xtech/hw-openmower-worx/README.md

# OpenMower Mainboard for Worx Mowers

## Information

This hardware version is in development. Nothing works, this is not nearly done!!

## About This Repo

OpenMower is an open-source project that upgrades off-the-shelf robotic mowers into modern, smart lawn mowing robots with RTK GPS technology. For more details, check out the [OpenMower project](https://github.com/clemensElflein/openmower).

This repository contains the design files for a custom mainboard specifically designed for converting YardForce mowers to OpenMower. 

## List of Compatible Mowers

This mainboard is compatible with the following mower models:

- YardForce Classic 500(B)
- YardForce SA-series mowers (SA650, SA900, ...)

## Additional Information

This mainboard is the reference board for OpenMower and includes more features than actually required to build an OpenMower robot. This way it can be used as a template for other mower models. Additional features include a gigabit Ethernet switch, LiPo charger, and a 12V auxiliary power supply for extensions.

## Patents, Local Laws, Liability

Before building a robot based on the designs published here, please make sure that you are allowed to do so in your specific regions.
There may be patents and / or laws prohibiting you of doing so.

The code/schematics/PCB files are distributed in the hope that it will be useful, but WITHOUT ANY WARRANTY; without even the implied warranty of MERCHANTABILITY or FITNESS FOR A PARTICULAR PURPOSE.

This basically means: I'm just documenting a project of mine here for free and I don't have the time and resources to check that devices built using this information will be safe to use, legal to use or even work as intended. You will need technical know-how to use this project and I'm not liable for any damages your devices do to anyone or anything.

## License

<br />This work is licensed under a <a rel="license" href="https://creativecommons.org/licenses/by/4.0/">Creative Commons Attribution 4.0 International License</a>.
