xtech/hw-openmower-worx/components/extern/3dmodels/Connectors/XT60PW-M.STEP

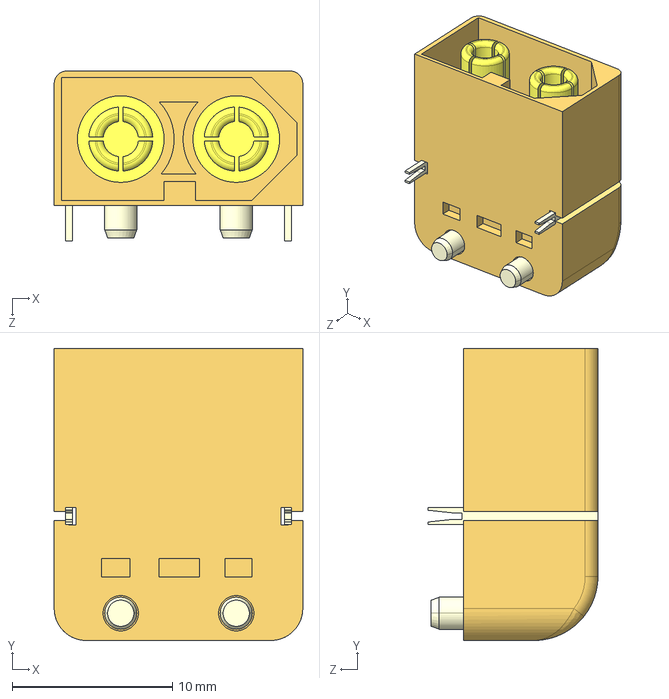
[picture p1: CAD file, 2024-10-06]
components/extern/3dmodels/Connectors/XT60PW-M.STEP
15.5 x 18.2 x 10.6 mm
