xtech/hw-openmower-worx/3d/FuseClip.stp

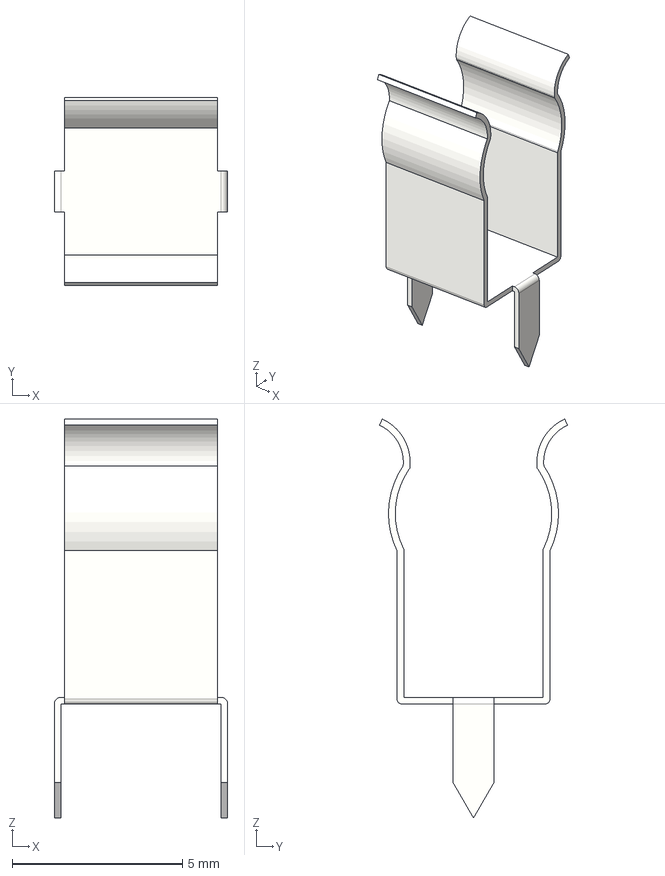
[picture p2: CAD file, 2024-10-06]
3d/FuseClip.stp
5.10 x 5.53 x 11.7 mm
