xtech/hw-openmower-worx/components/extern/3dmodels/Connectors/XT60PW FEMALE.STEP

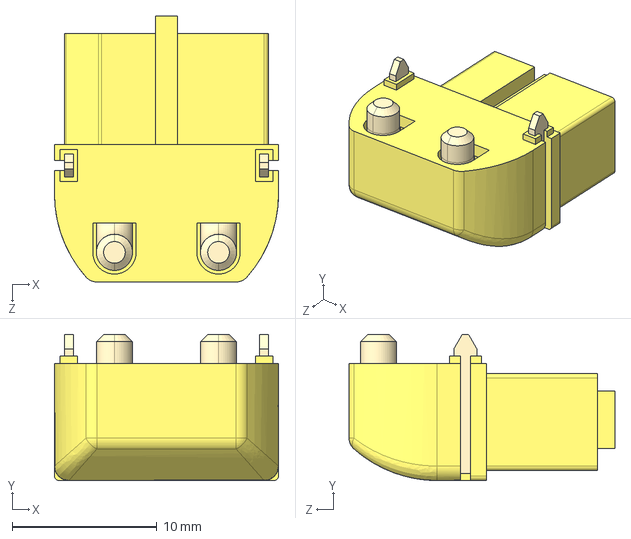
[picture p3: CAD file, 2024-10-06]
components/extern/3dmodels/Connectors/XT60PW FEMALE.STEP
15.5 x 10.1 x 18.4 mm
