xtech/hw-openmower-worx/components/extern/3dmodels/Connectors/XT60PW MALE.STEP

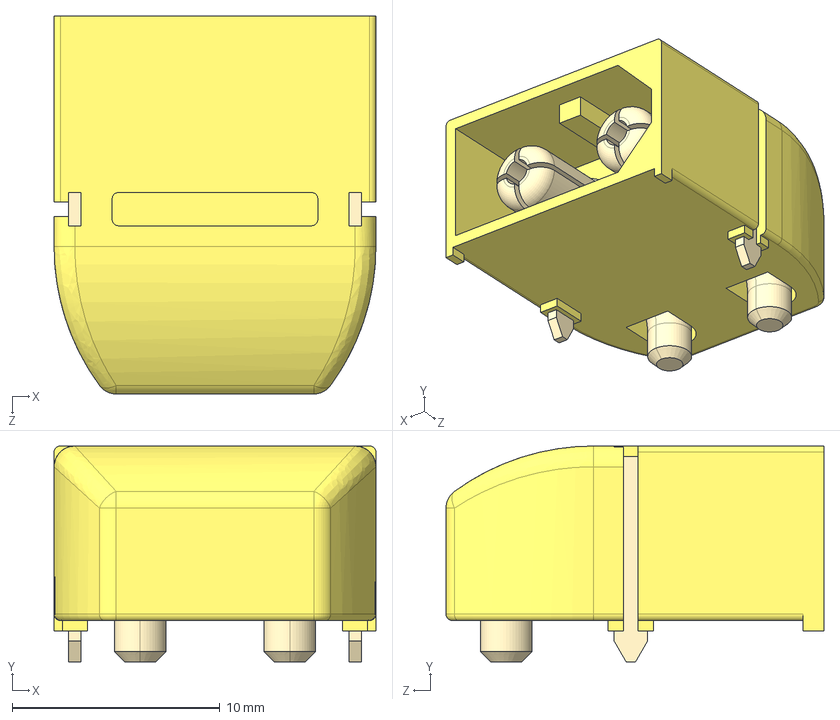
[picture p6: CAD file, 2024-10-06]
components/extern/3dmodels/Connectors/XT60PW MALE.STEP
15.5 x 10.4 x 18.2 mm
