xtech/hw-openmower-worx/3d/039281083_stp/039281083.stp

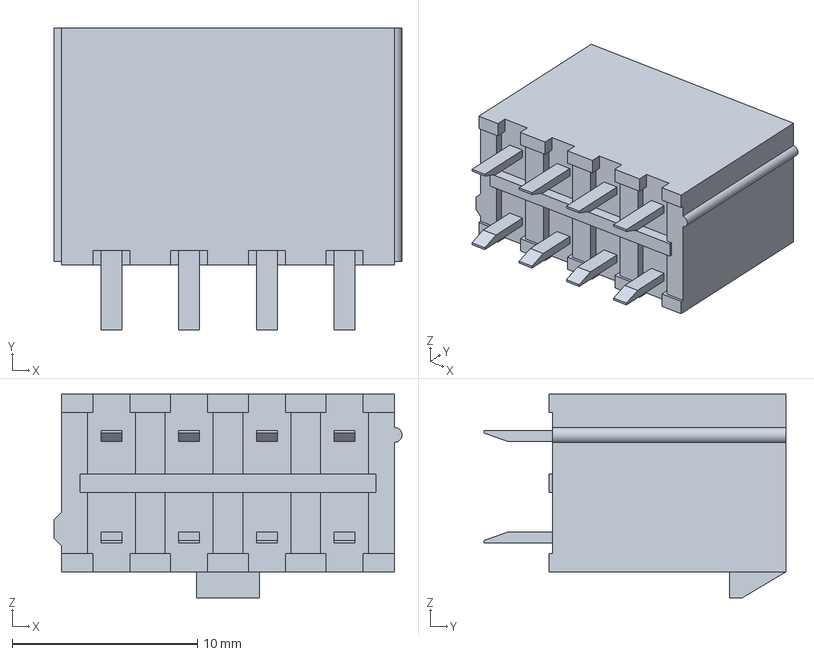
[picture p8: CAD file, 2024-10-06]
3d/039281083_stp/039281083.stp
18.8 x 16.3 x 11.0 mm
