xtech/hw-openmower-worx/components/extern/3dmodels/local_CHARGER/BQ25756RRVR.step

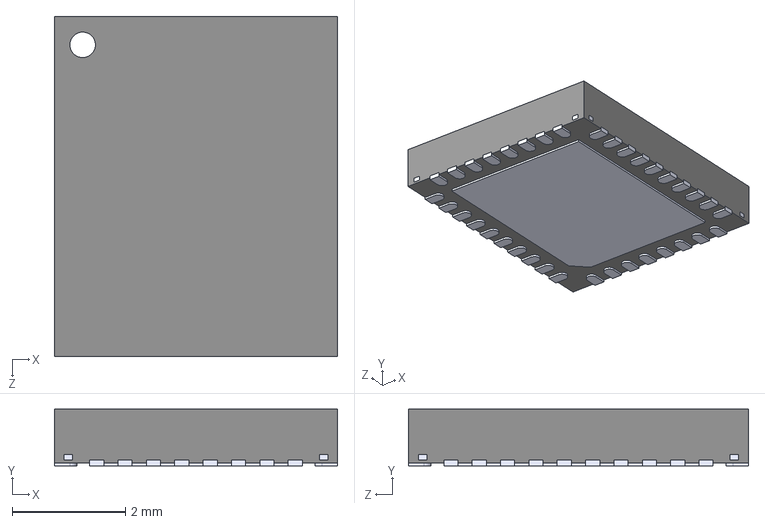
[picture p11: CAD file, 2024-10-06]
components/extern/3dmodels/local_CHARGER/BQ25756RRVR.step
5.00 x 1.00 x 6.00 mm
