xtech/hw-openmower-worx/Amplifier.kicad_sch

## KiCad design Amplifier.kicad_sch (2024-10-06)

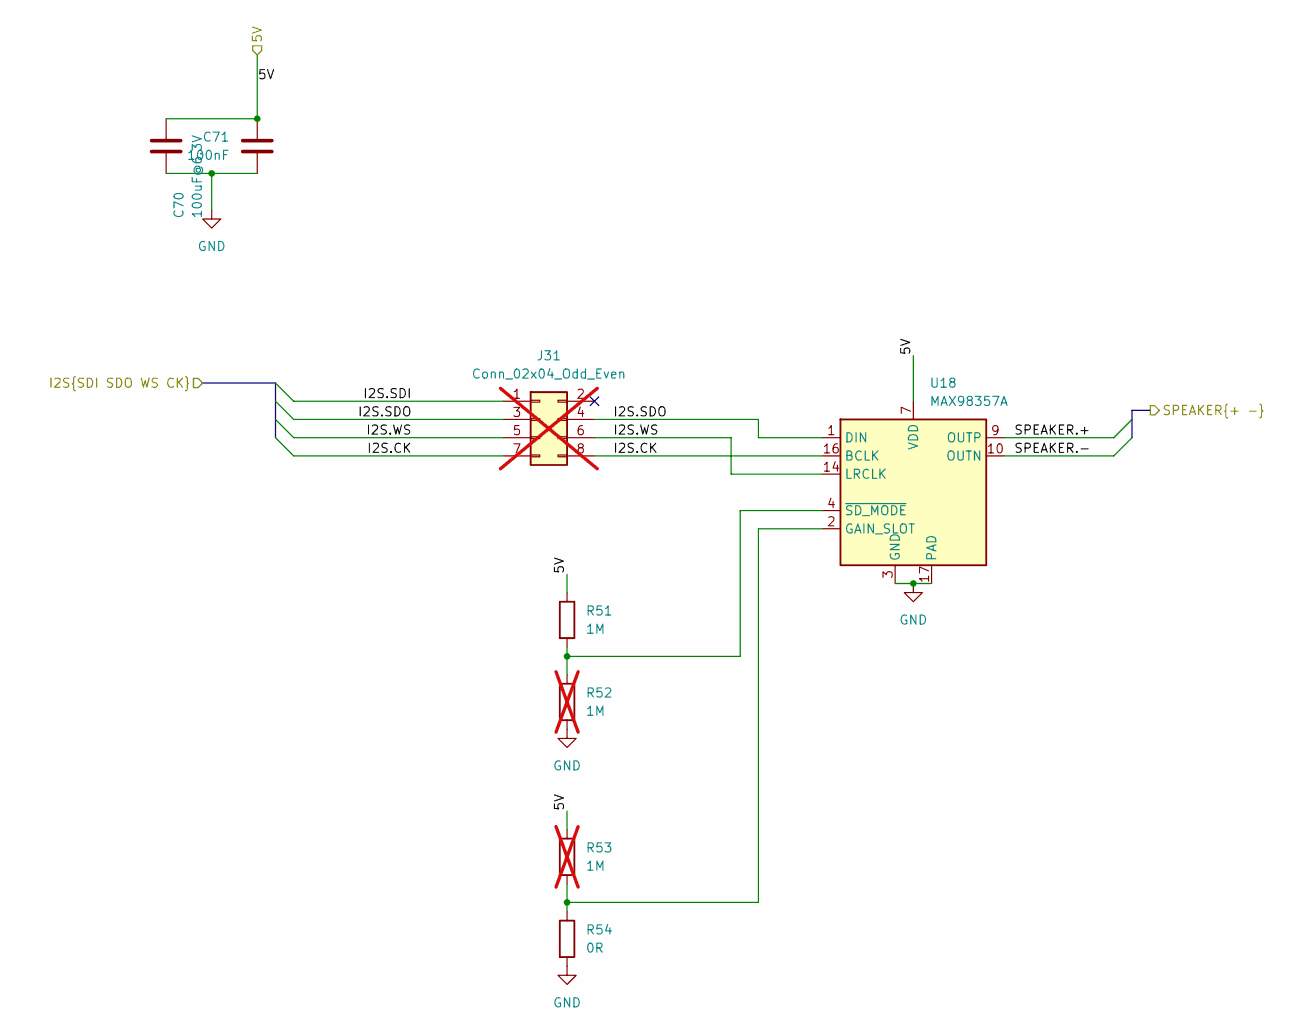
[picture p14: schematic Amplifier.kicad_sch]

Parts:
C70: 100uF@6.3V; C_1206_3216Metric; JLC C15008
C71: 100nF; C_0402_1005Metric; JLC C307331
J31: Conn_02x04_Odd_Even; PinHeader_2x04_P2.54mm_Vertical; not fitted
R51: 1M; R_0805_2012Metric; JLC C17514
R52, R53: 1M; R_0805_2012Metric; JLC C17514; not fitted
R54: 0R; R_0805_2012Metric; JLC C17477
U18: MAX98357A; TQFN-16-1EP_3x3mm_P0.5mm_EP1.23x1.23mm; JLC C910544

Connections:
5V: C70.1, C71.2, R51.1, R53.1, U18.7 (VDD), U18.8 (VDD)
GND: C70.2, C71.1, R52.2, R54.2, U18.3 (GND), U18.11 (GND), U18.15 (GND), U18.17 (PAD)
I2S.CK: J31.7, J31.8, U18.16 (BCLK)
I2S.SDI: J31.1
I2S.SDO: J31.3, J31.4, U18.1 (DIN)
I2S.WS: J31.5, J31.6, U18.14 (LRCLK)
unnamed: R51.2, R52.1, U18.4 (~SD_MODE)
unnamed: R53.2, R54.1, U18.2 (GAIN_SLOT)
SPEAKER.+: U18.9 (OUTP)
SPEAKER.-: U18.10 (OUTN)
