xtech/hw-openmower-worx/AuxPSU.kicad_sch

## KiCad design AuxPSU.kicad_sch (2024-10-06)

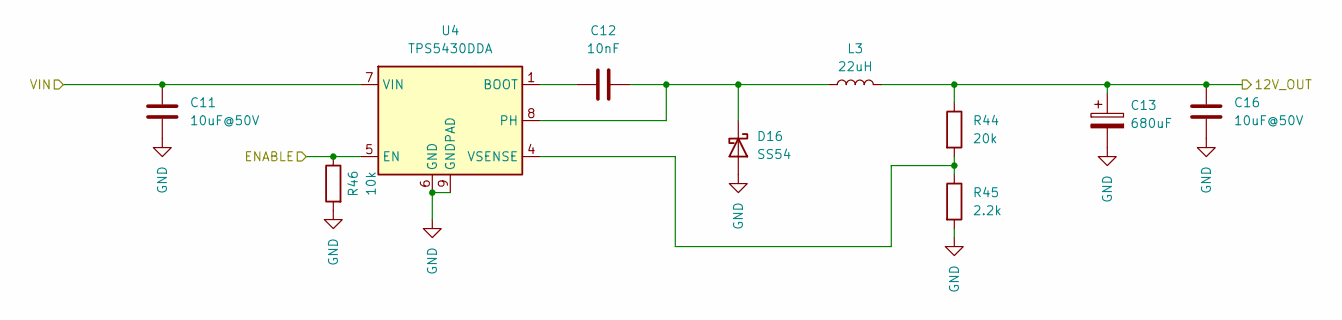
[picture p15: schematic AuxPSU.kicad_sch]

Parts:
C11, C16: 10uF@50V; C_1206_3216Metric; JLC C13585
C12: 10nF; C_0805_2012Metric; JLC C1710
C13: 680uF; CP_Elec_10x12.5; Part Number GVM1V681M1010; Digikey P124828TR-ND
D16: SS54; D_SMA; JLC C22452
L3: 22uH; L_Sunlord_MWSA1004S; JLC C408489
R44: 20k; R_0805_2012Metric; JLC C4328
R45: 2.2k; R_0805_2012Metric; JLC C17520
R46: 10k; R_0402_1005Metric; JLC C25744
U4: TPS5430DDA; TI_SO-PowerPAD-8_ThermalVias; JLC C9864

Connections:
12V_OUT: C13.1, C16.1, L3.2, R44.1
ENABLE: R46.1, U4.5 (EN)
GND: C11.2, C13.2, C16.2, D16.2 (A), R45.2, R46.2, U4.6 (GND), U4.9 (GNDPAD)
unnamed: C12.1, U4.1 (BOOT)
unnamed: C12.2, D16.1 (K), L3.1, U4.8 (PH)
unnamed: R44.2, R45.1, U4.4 (VSENSE)
VIN: C11.1, U4.7 (VIN)
