xtech/hw-openmower-worx/Charger.kicad_sch

## KiCad design Charger.kicad_sch (2024-10-06)

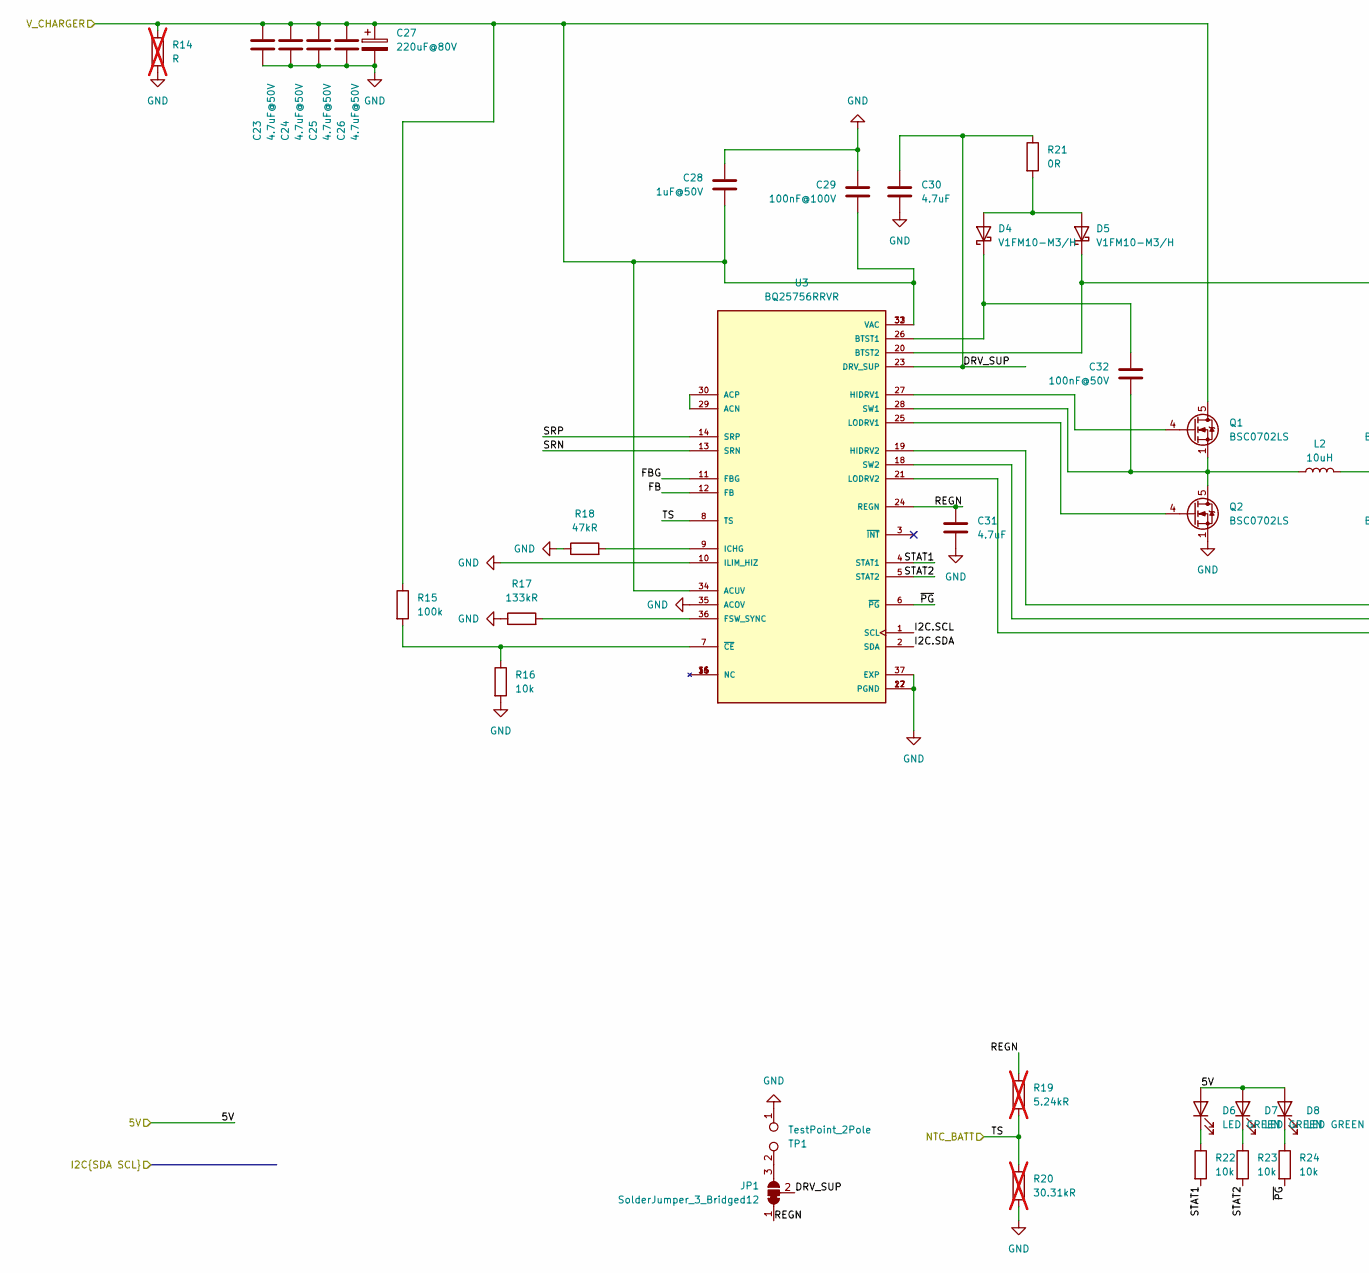
[picture p16: schematic Charger.kicad_sch, part in row 1, column 1]

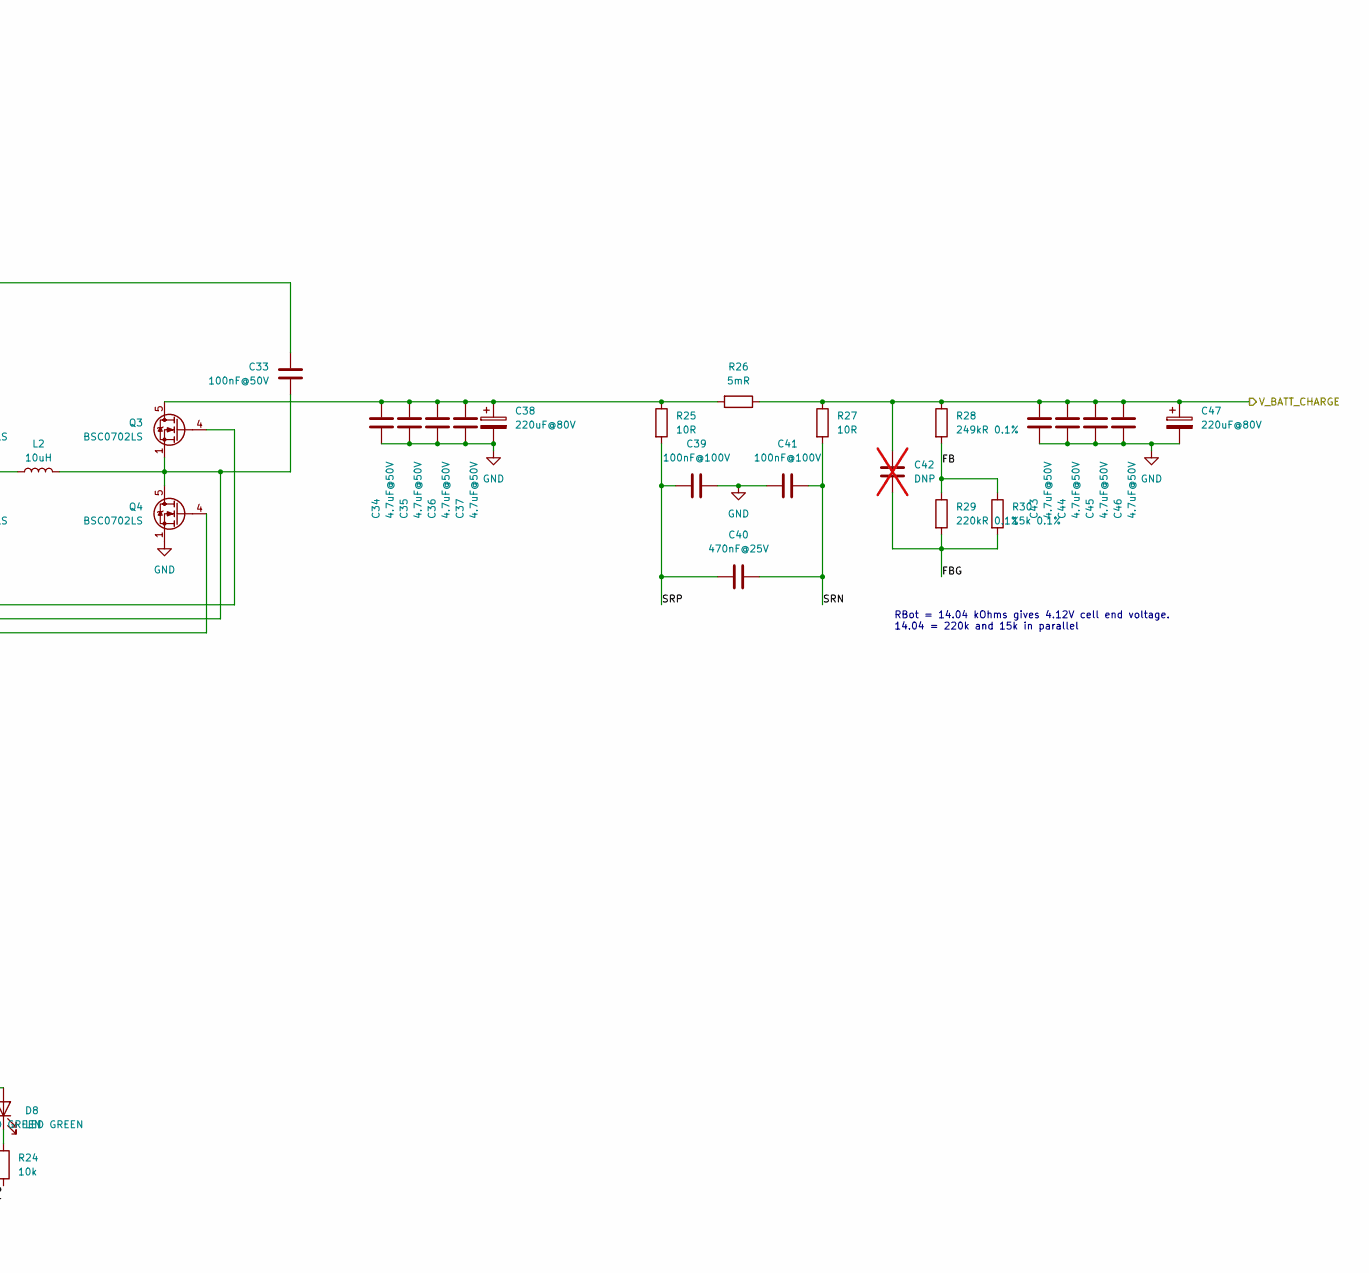
[picture p17: schematic Charger.kicad_sch, part in row 1, column 2]

Parts:
C23, C24, C25, C26, C34, C35, C36, C37, C43, C44, C45, C46: 4.7uF@50V; C_1206_3216Metric; JLC C29823
C27, C38, C47: 220uF@80V; CP_Radial_D10.0mm_P5.00mm; JLC C106516
C28: 1uF@50V; C_0805_2012Metric; JLC C354368
C29, C39, C41: 100nF@100V; C_0805_2012Metric; JLC C28233
C30, C31: 4.7uF; C_0805_2012Metric; JLC C1779
C32, C33: 100nF@50V; C_0402_1005Metric; JLC C307331
C40: 470nF@25V; C_0603_1608Metric; JLC C1623
C42: DNP; C_0603_1608Metric; not fitted
D4, D5: V1FM10-M3/H; D_SMF; JLC C3758930
D6, D7, D8: LED GREEN; LED_0805_2012Metric; JLC C2297
JP1: SolderJumper_3_Bridged12; SolderJumper-3_P1.3mm_Bridged12_Pad1.0x1.5mm
L2: 10uH; L_Sunlord_MWSA1004S; JLC C408487
Q1, Q2, Q3, Q4: BSC0702LS; TDSON-8-1; JLC C501503
R14: R; R_1206_3216Metric; not fitted
R15: 100k; R_0402_1005Metric; JLC C25741
R16, R22, R23, R24: 10k; R_0402_1005Metric; JLC C25744
R17: 133kR; R_0603_1608Metric; JLC C227577
R18: 47kR; R_0603_1608Metric; JLC C25819
R19: 5.24kR; R_0603_1608Metric; not fitted
R20: 30.31kR; R_0603_1608Metric; not fitted
R21: 0R; R_0805_2012Metric; JLC C17477
R25, R27: 10R; R_0402_1005Metric; JLC C25077
R26: 5mR; R_2512_6332Metric; JLC C309526
R28: 249kR 0.1%; R_0603_1608Metric; JLC C705752
R29: 220kR 0.1%; R_0603_1608Metric; JLC C861231
R30: 15k 0.1%; R_0603_1608Metric; JLC C2692707
TP1: TestPoint_2Pole; PinHeader_1x02_P2.54mm_Vertical
U3: BQ25756RRVR; PARTREV August 2023; JLC C19272232

Connections:
5V: D6.2 (A), D7.2 (A), D8.2 (A)
DRV_SUP: C30.1, JP1.2 (C), R21.1, U3.23 (DRV_SUP)
FB: R28.2, R29.1, R30.1, U3.12 (FB)
FBG: C42.2, R29.2, R30.2, U3.11 (FBG)
GND: C23.2, C24.2, C25.2, C26.2, C27.2, C28.2, C29.2, C30.2, C31.2, C34.2, C35.2, C36.2, C37.2, C38.2, C39.1, C41.2, C43.2, C44.2, C45.2, C46.2, C47.2, Q2.1 (S), Q2.2 (S), Q2.3 (S), Q4.1 (S), Q4.2 (S), Q4.3 (S), R14.2, R16.2, R17.1, R18.1, R20.2, TP1.1, U3.10 (ILIM_HIZ), U3.17 (PGND), U3.22 (PGND), U3.35 (ACOV), U3.37 (EXP)
I2C.SCL: U3.1 (SCL)
I2C.SDA: U3.2 (SDA)
NTC_BATT: R19.2, R20.1, U3.8 (TS)
unnamed: C32.1, L2.1, Q1.1 (S), Q1.2 (S), Q1.3 (S), Q2.5 (D), U3.28 (SW1)
unnamed: C32.2, D4.1 (K), U3.26 (BTST1)
unnamed: C33.1, L2.2, Q3.1 (S), Q3.2 (S), Q3.3 (S), Q4.5 (D), U3.18 (SW2)
unnamed: C33.2, D5.1 (K), U3.20 (BTST2)
unnamed: C34.1, C35.1, C36.1, C37.1, C38.1, Q3.5 (D), R25.1, R26.2
unnamed: D4.2 (A), D5.2 (A), R21.2
unnamed: D6.1 (K), R22.1
unnamed: D7.1 (K), R23.1
unnamed: D8.1 (K), R24.1
unnamed: JP1.3 (B), TP1.2
unnamed: Q1.4 (G), U3.27 (HIDRV1)
unnamed: Q2.4 (G), U3.25 (LODRV1)
unnamed: Q3.4 (G), U3.19 (HIDRV2)
unnamed: Q4.4 (G), U3.21 (LODRV2)
unnamed: R15.2, R16.1, U3.7 (~CE)
unnamed: R17.2, U3.36 (FSW_SYNC)
unnamed: R18.2, U3.9 (ICHG)
unnamed: U3.15 (NC), U3.16 (NC), U3.31 (NC)
unnamed: U3.29 (ACN), U3.30 (ACP)
REGN: C31.1, JP1.1 (A), R19.1, U3.24 (REGN)
SRN: C40.2, C41.1, R27.2, U3.13 (SRN)
SRP: C39.2, C40.1, R25.2, U3.14 (SRP)
STAT1: R22.2, U3.4 (STAT1)
STAT2: R23.2, U3.5 (STAT2)
V_BATT_CHARGE: C42.1, C43.1, C44.1, C45.1, C46.1, C47.1, R26.1, R27.1, R28.1
V_CHARGER: C23.1, C24.1, C25.1, C26.1, C27.1, C28.1, C29.1, Q1.5 (D), R14.1, R15.1, U3.32 (VAC), U3.33 (VAC), U3.34 (ACUV)
~PG: R24.2, U3.6 (~PG)

Notes on the sheet:
RBot = 14.04 kOhms gives 4.12V cell end voltage. 14.04 = 220k and 15k in parallel
