xtech/hw-openmower-worx/Connectors.kicad_sch

## KiCad design Connectors.kicad_sch (2024-10-06)

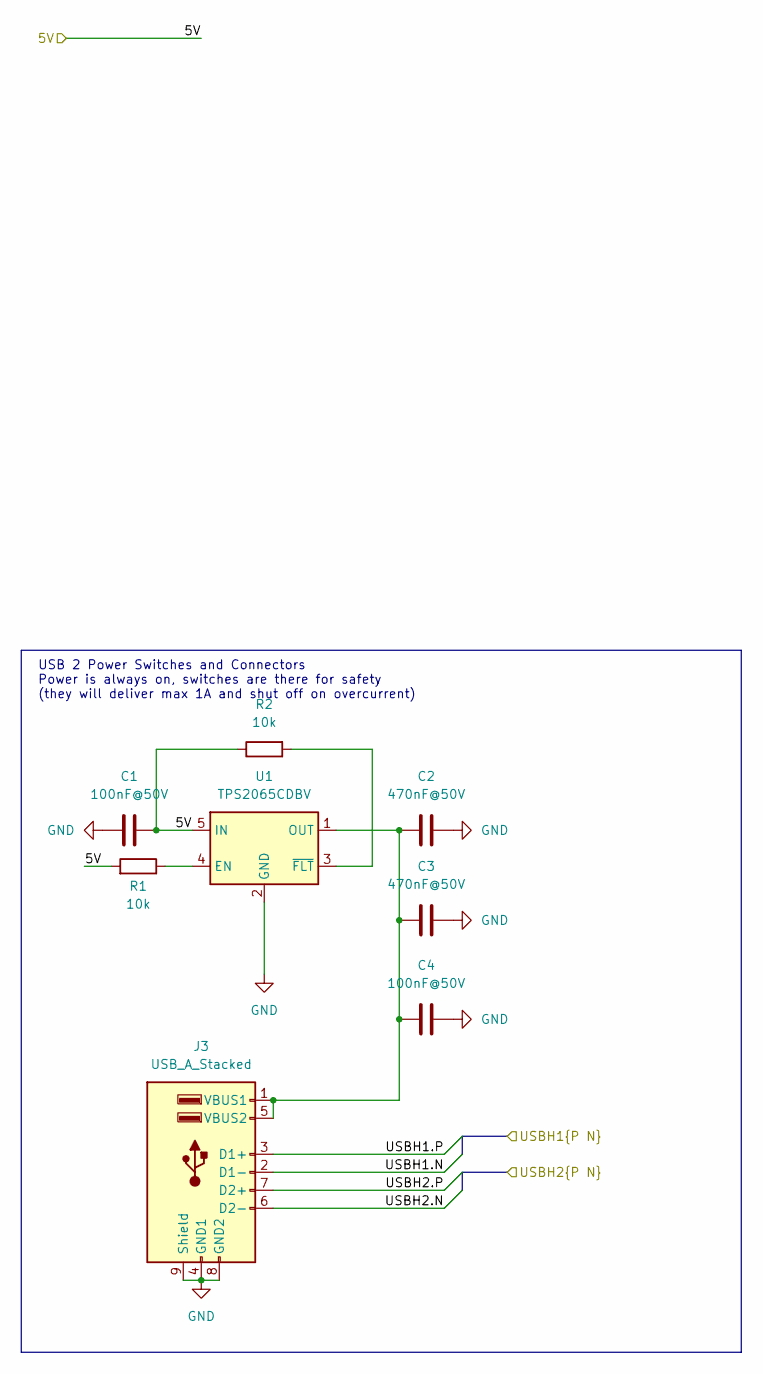
[picture p18: schematic Connectors.kicad_sch]

Parts:
C1, C4: 100nF@50V; C_0402_1005Metric; JLC C307331
C2, C3: 470nF@50V; C_0805_2012Metric; JLC C13967
J3: USB_A_Stacked; USB_A_Wuerth_61400826021_Horizontal_Stacked; JLC C720548
R1, R2: 10k; R_0402_1005Metric; JLC C25744
U1: TPS2065CDBV; SOT-23-5; JLC C353882

Connections:
5V: C1.1, R1.2, R2.1, U1.5 (IN)
GND: C1.2, C2.2, C3.2, C4.1, J3.4 (GND1), J3.8 (GND2), J3.9 (Shield), U1.2 (GND)
unnamed: C2.1, C3.1, C4.2, J3.1 (VBUS1), J3.5 (VBUS2), U1.1 (OUT)
unnamed: R1.1, U1.4 (EN)
unnamed: R2.2, U1.3 (~FLT)
USBH1.N: J3.2 (D1-)
USBH1.P: J3.3 (D1+)
USBH2.N: J3.6 (D2-)
USBH2.P: J3.7 (D2+)

Notes on the sheet:
USB 2 Power Switches and Connectors Power is always on, switches are there for safety (they will deliver max 1A and shut off on overcurrent)
