xtech/hw-openmower-worx/Core.kicad_sch

## KiCad design Core.kicad_sch (2024-10-06)

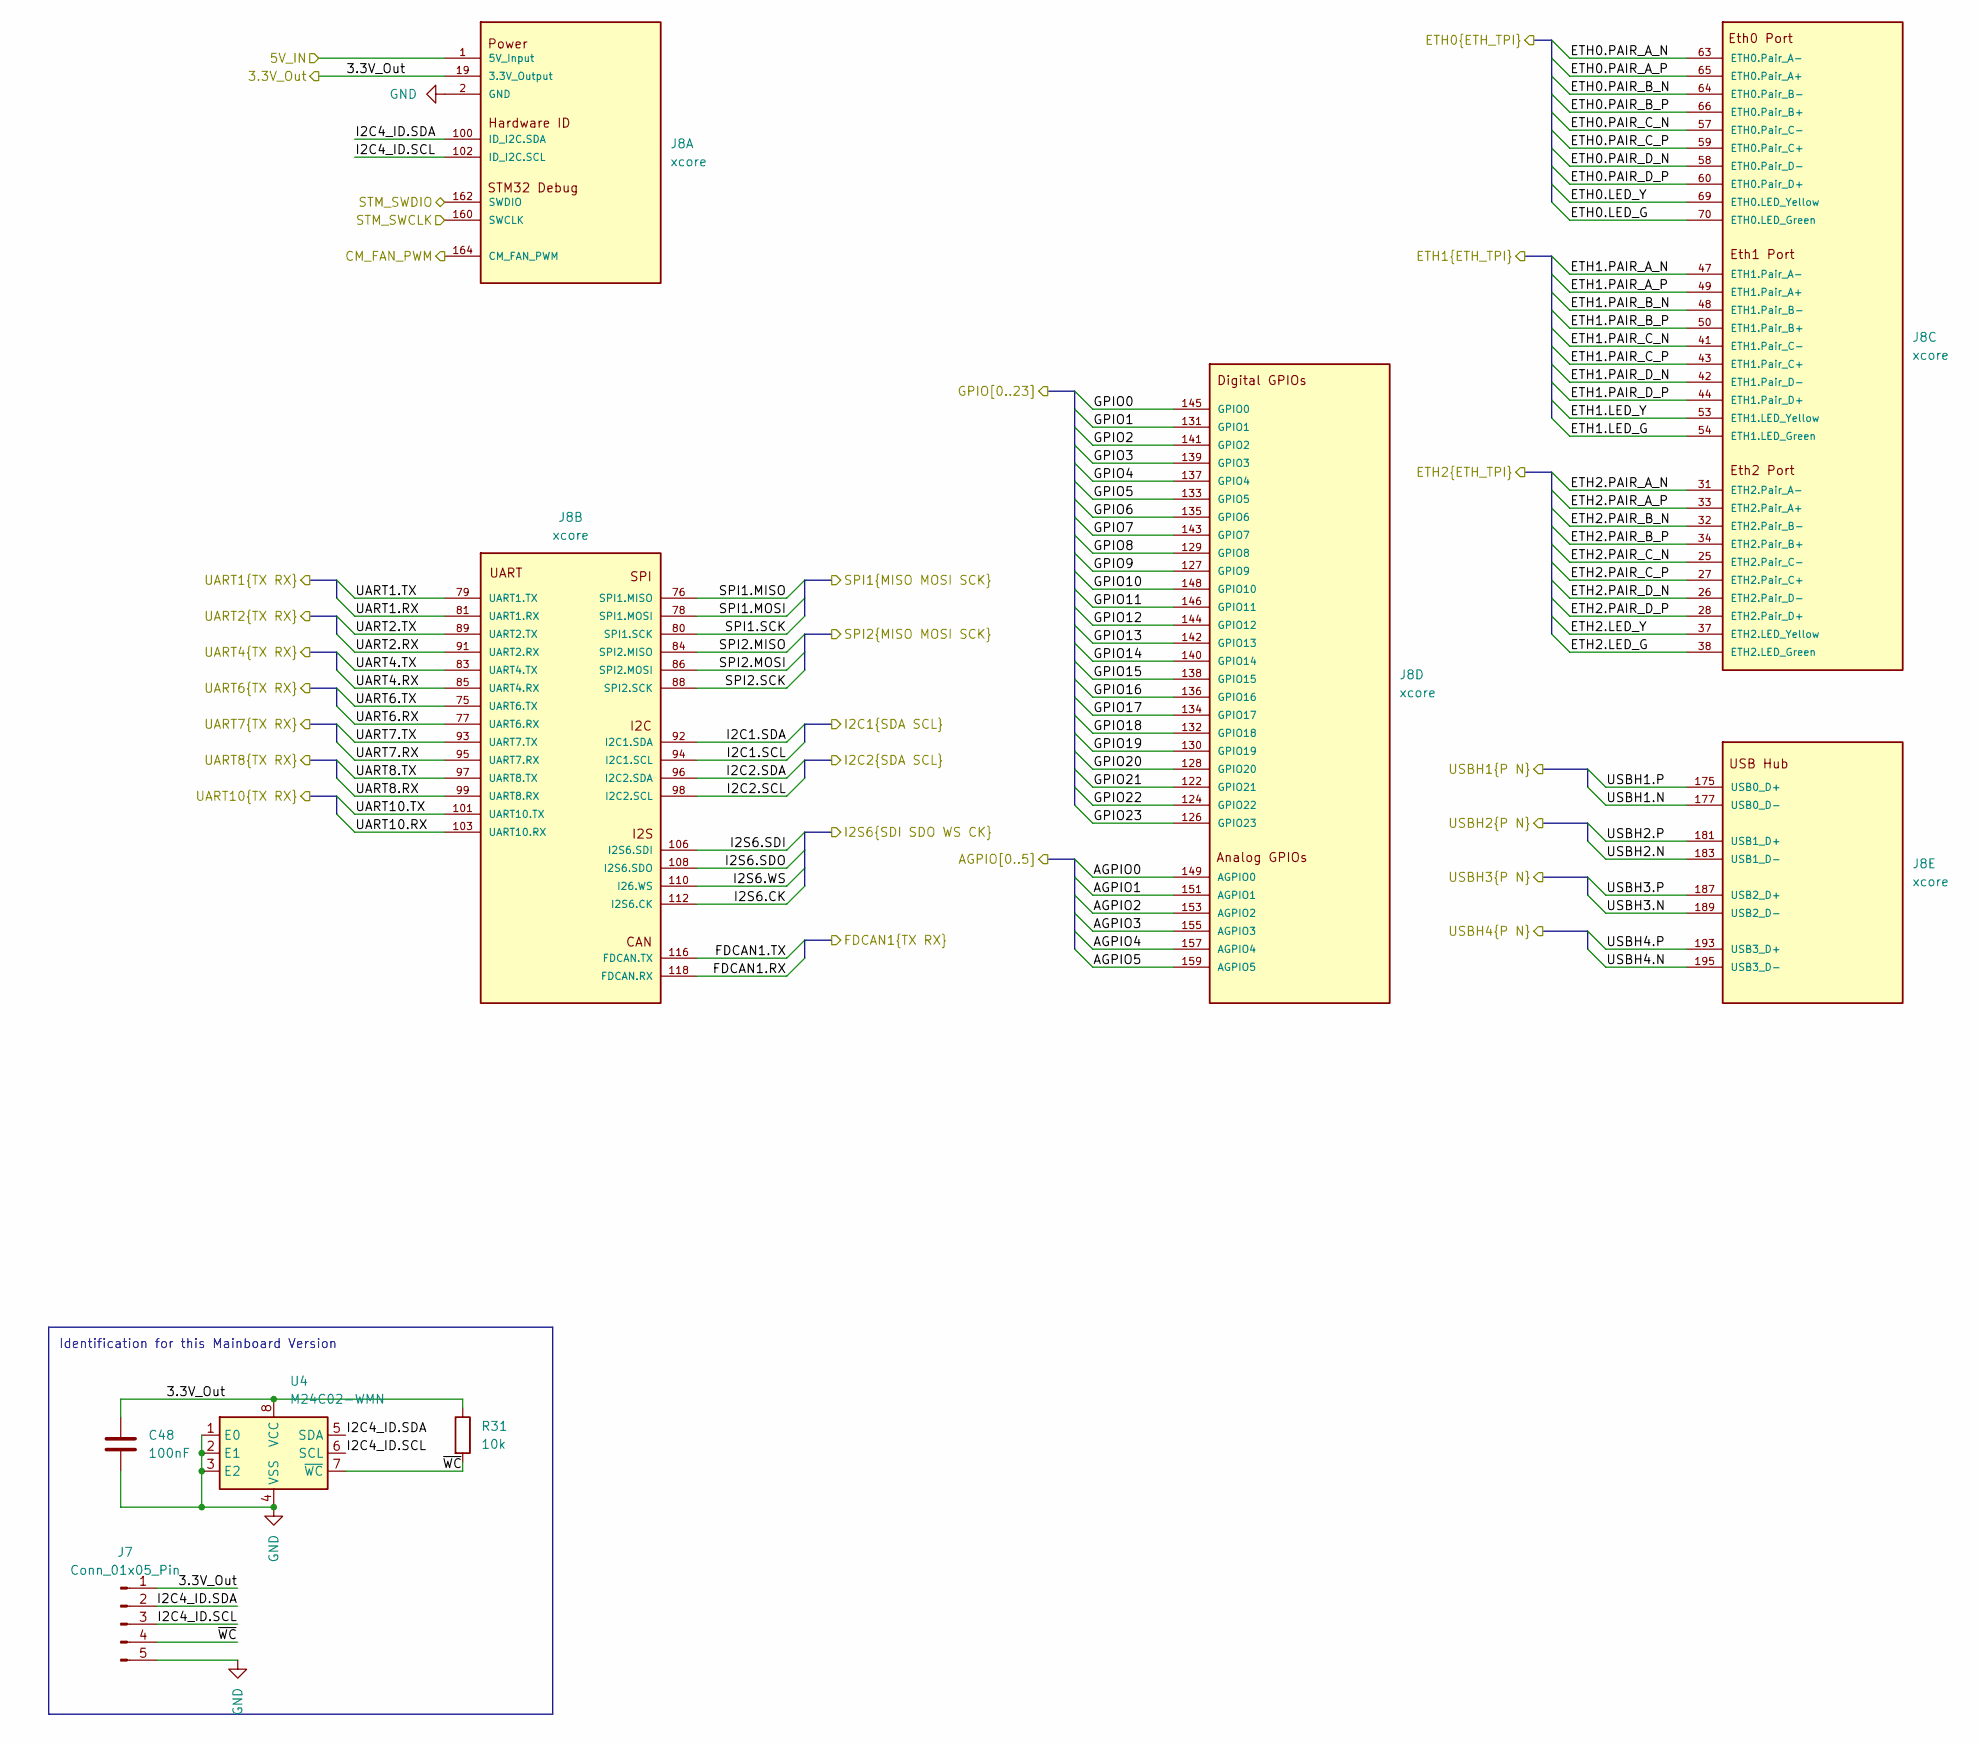
[picture p19: schematic Core.kicad_sch]

Parts:
C48: 100nF; C_0402_1005Metric; JLC C307331
J7: Conn_01x05_Pin; PinHeader_1x05_P2.54mm_Vertical; JLC C6332198
J8: xcore
R31: 10k; R_0402_1005Metric; JLC C25744
U4: M24C02-WMN; SOIC-8_3.9x4.9mm_P1.27mm; JLC C7562

Connections:
3.3V_Out: C48.1, J7.1, J8.19 (3.3V_Output), J8.21 (3.3V_Output), R31.1, U4.8 (VCC)
5V_IN: J8.1 (5V_Input), J8.3 (5V_Input), J8.5 (5V_Input), J8.7 (5V_Input), J8.9 (5V_Input), J8.11 (5V_Input), J8.13 (5V_Input), J8.15 (5V_Input), J8.17 (5V_Input)
AGPIO0: J8.149 (AGPIO0)
AGPIO1: J8.151 (AGPIO1)
AGPIO2: J8.153 (AGPIO2)
AGPIO3: J8.155 (AGPIO3)
AGPIO4: J8.157 (AGPIO4)
AGPIO5: J8.159 (AGPIO5)
CM_FAN_PWM: J8.164 (CM_FAN_PWM)
ETH0.LED_G: J8.70 (ETH0.LED_Green)
ETH0.LED_Y: J8.69 (ETH0.LED_Yellow)
ETH0.PAIR_A_N: J8.63 (ETH0.Pair_A-)
ETH0.PAIR_A_P: J8.65 (ETH0.Pair_A+)
ETH0.PAIR_B_N: J8.64 (ETH0.Pair_B-)
ETH0.PAIR_B_P: J8.66 (ETH0.Pair_B+)
ETH0.PAIR_C_N: J8.57 (ETH0.Pair_C-)
ETH0.PAIR_C_P: J8.59 (ETH0.Pair_C+)
ETH0.PAIR_D_N: J8.58 (ETH0.Pair_D-)
ETH0.PAIR_D_P: J8.60 (ETH0.Pair_D+)
ETH1.LED_G: J8.54 (ETH1.LED_Green)
ETH1.LED_Y: J8.53 (ETH1.LED_Yellow)
ETH1.PAIR_A_N: J8.47 (ETH1.Pair_A-)
ETH1.PAIR_A_P: J8.49 (ETH1.Pair_A+)
ETH1.PAIR_B_N: J8.48 (ETH1.Pair_B-)
ETH1.PAIR_B_P: J8.50 (ETH1.Pair_B+)
ETH1.PAIR_C_N: J8.41 (ETH1.Pair_C-)
ETH1.PAIR_C_P: J8.43 (ETH1.Pair_C+)
ETH1.PAIR_D_N: J8.42 (ETH1.Pair_D-)
ETH1.PAIR_D_P: J8.44 (ETH1.Pair_D+)
ETH2.LED_G: J8.38 (ETH2.LED_Green)
ETH2.LED_Y: J8.37 (ETH2.LED_Yellow)
ETH2.PAIR_A_N: J8.31 (ETH2.Pair_A-)
ETH2.PAIR_A_P: J8.33 (ETH2.Pair_A+)
ETH2.PAIR_B_N: J8.32 (ETH2.Pair_B-)
ETH2.PAIR_B_P: J8.34 (ETH2.Pair_B+)
ETH2.PAIR_C_N: J8.25 (ETH2.Pair_C-)
ETH2.PAIR_C_P: J8.27 (ETH2.Pair_C+)
ETH2.PAIR_D_N: J8.26 (ETH2.Pair_D-)
ETH2.PAIR_D_P: J8.28 (ETH2.Pair_D+)
FDCAN1.RX: J8.118 (FDCAN.RX)
FDCAN1.TX: J8.116 (FDCAN.TX)
GND: C48.2, J7.5, J8.2 (GND), J8.4 (GND), J8.6 (GND), J8.8 (GND), J8.10 (GND), J8.12 (GND), J8.14 (GND), J8.16 (GND), J8.18 (GND), J8.23 (GND), J8.24 (GND), J8.29 (GND), J8.30 (GND), J8.35 (GND), J8.36 (GND), J8.39 (GND), J8.40 (GND), J8.45 (GND), J8.46 (GND), J8.51 (GND), J8.52 (GND), J8.55 (GND), J8.56 (GND), J8.61 (GND), J8.62 (GND), J8.67 (GND), J8.68 (GND), J8.71 (GND), J8.72 (GND), J8.73 (GND), J8.74 (GND), J8.82 (GND), J8.87 (GND), J8.90 (GND), J8.104 (GND), J8.114 (GND), J8.120 (GND), J8.147 (GND), J8.168 (GND), J8.173 (GND), J8.174 (GND), J8.179 (GND), J8.180 (GND), J8.185 (GND), J8.186 (GND), J8.191 (GND), J8.192 (GND), J8.197 (GND), J8.198 (GND), J8.203 (GND), J8.204 (GND), J8.SH1 (GND), J8.SH2 (GND), U4.1 (E0), U4.2 (E1), U4.3 (E2), U4.4 (VSS)
GPIO0: J8.145 (GPIO0)
GPIO1: J8.131 (GPIO1)
GPIO2: J8.141 (GPIO2)
GPIO3: J8.139 (GPIO3)
GPIO4: J8.137 (GPIO4)
GPIO5: J8.133 (GPIO5)
GPIO6: J8.135 (GPIO6)
GPIO7: J8.143 (GPIO7)
GPIO8: J8.129 (GPIO8)
GPIO9: J8.127 (GPIO9)
GPIO10: J8.148 (GPIO10)
GPIO11: J8.146 (GPIO11)
GPIO12: J8.144 (GPIO12)
GPIO13: J8.142 (GPIO13)
GPIO14: J8.140 (GPIO14)
GPIO15: J8.138 (GPIO15)
GPIO16: J8.136 (GPIO16)
GPIO17: J8.134 (GPIO17)
GPIO18: J8.132 (GPIO18)
GPIO19: J8.130 (GPIO19)
GPIO20: J8.128 (GPIO20)
GPIO21: J8.122 (GPIO21)
GPIO22: J8.124 (GPIO22)
GPIO23: J8.126 (GPIO23)
I2C1.SCL: J8.94 (I2C1.SCL)
I2C1.SDA: J8.92 (I2C1.SDA)
I2C2.SCL: J8.98 (I2C2.SCL)
I2C2.SDA: J8.96 (I2C2.SDA)
I2C4_ID.SCL: J7.3, J8.102 (ID_I2C.SCL), U4.6 (SCL)
I2C4_ID.SDA: J7.2, J8.100 (ID_I2C.SDA), U4.5 (SDA)
I2S6.CK: J8.112 (I2S6.CK)
I2S6.SDI: J8.106 (I2S6.SDI)
I2S6.SDO: J8.108 (I2S6.SDO)
I2S6.WS: J8.110 (I26.WS)
SPI1.MISO: J8.76 (SPI1.MISO)
SPI1.MOSI: J8.78 (SPI1.MOSI)
SPI1.SCK: J8.80 (SPI1.SCK)
SPI2.MISO: J8.84 (SPI2.MISO)
SPI2.MOSI: J8.86 (SPI2.MOSI)
SPI2.SCK: J8.88 (SPI2.SCK)
STM_SWCLK: J8.160 (SWCLK)
STM_SWDIO: J8.162 (SWDIO)
UART1.RX: J8.81 (UART1.RX)
UART1.TX: J8.79 (UART1.TX)
UART2.RX: J8.91 (UART2.RX)
UART2.TX: J8.89 (UART2.TX)
UART4.RX: J8.85 (UART4.RX)
UART4.TX: J8.83 (UART4.TX)
UART6.RX: J8.77 (UART6.RX)
UART6.TX: J8.75 (UART6.TX)
UART7.RX: J8.95 (UART7.RX)
UART7.TX: J8.93 (UART7.TX)
UART8.RX: J8.99 (UART8.RX)
UART8.TX: J8.97 (UART8.TX)
UART10.RX: J8.103 (UART10.RX)
UART10.TX: J8.101 (UART10.TX)
USBH1.N: J8.177 (USB0_D-)
USBH1.P: J8.175 (USB0_D+)
USBH2.N: J8.183 (USB1_D-)
USBH2.P: J8.181 (USB1_D+)
USBH3.N: J8.189 (USB2_D-)
USBH3.P: J8.187 (USB2_D+)
USBH4.N: J8.195 (USB3_D-)
USBH4.P: J8.193 (USB3_D+)
~WC: J7.4, R31.2, U4.7 (~WC)

Notes on the sheet:
Identification for this Mainboard Version
