xtech/hw-openmower-worx/DCDC.kicad_sch

## KiCad design DCDC.kicad_sch (2024-10-06)

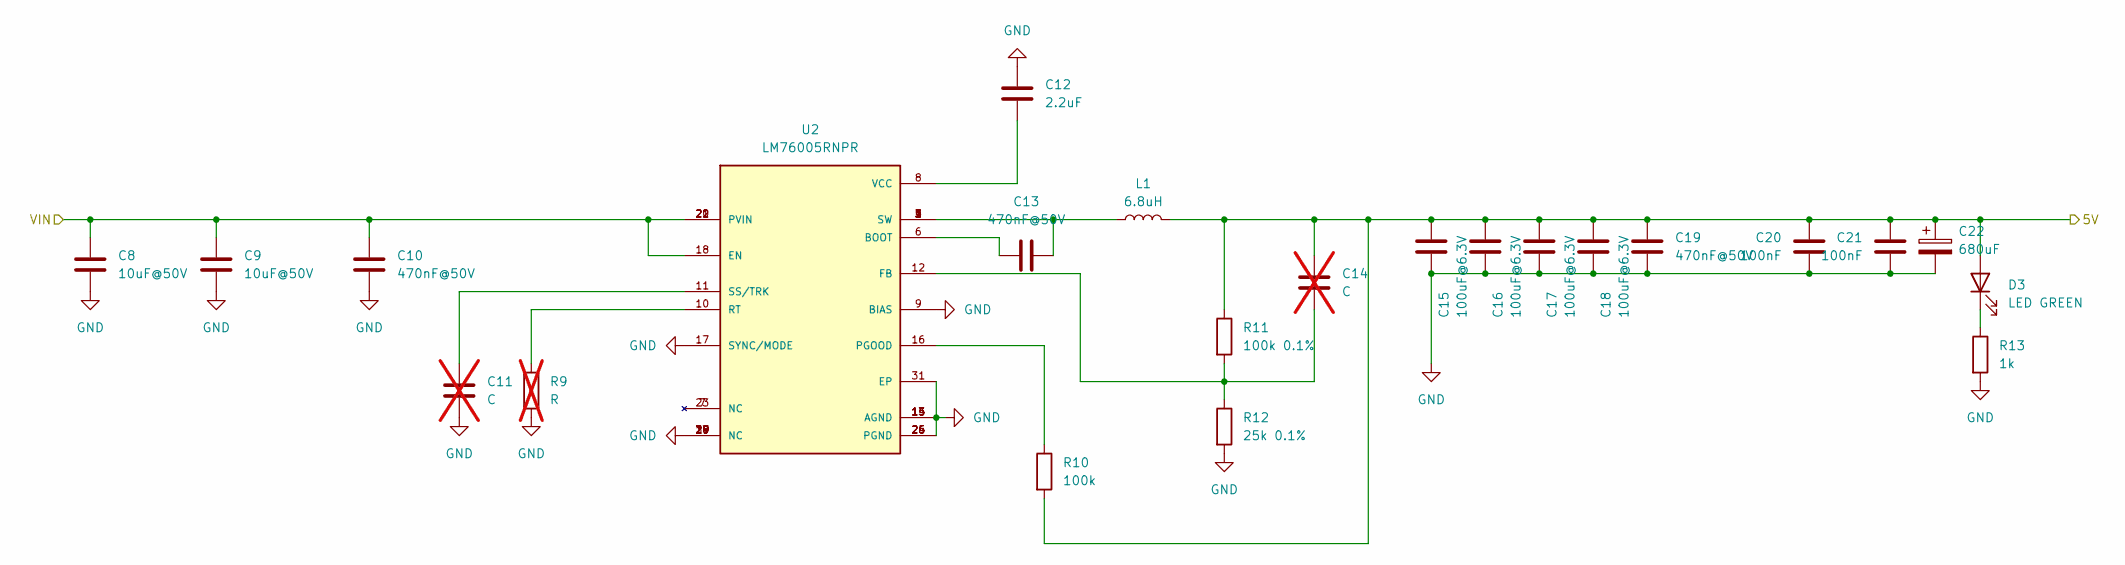
[picture p20: schematic DCDC.kicad_sch]

Parts:
C8, C9: 10uF@50V; C_1206_3216Metric; JLC C13585
C10, C13, C19: 470nF@50V; C_0805_2012Metric; JLC C13967
C11, C14: C; C_0805_2012Metric; not fitted
C12: 2.2uF; C_0805_2012Metric; JLC C377773
C15, C16, C17, C18: 100uF@6.3V; C_1206_3216Metric; JLC C15008
C20, C21: 100nF; C_0402_1005Metric; JLC C307331
C22: 680uF; CP_Elec_10x12.5; Part Number GVM1V681M1010; Digikey P124828TR-ND
D3: LED GREEN; LED_0805_2012Metric; JLC C2297
L1: 6.8uH; L_Sunlord_MWSA1004S; JLC C408485
R9: R; R_0805_2012Metric; not fitted
R10: 100k; R_0805_2012Metric; JLC C149504
R11: 100k 0.1%; R_0805_2012Metric; JLC C149504
R12: 25k 0.1%; R_0805_2012Metric; JLC C153306
R13: 1k; R_0805_2012Metric; JLC C17513
U2: LM76005RNPR; PARTREV A; JLC C2866241

Connections:
5V: C14.1, C15.1, C16.1, C17.1, C18.1, C19.1, C20.2, C21.2, C22.1, D3.2 (A), L1.2, R10.2, R11.1
GND: C8.2, C9.2, C10.2, C11.2, C12.1, C15.2, C16.2, C17.2, C18.2, C19.2, C20.1, C21.1, C22.2, R9.2, R12.2, R13.2, U2.9 (BIAS), U2.13 (AGND), U2.14 (AGND), U2.15 (AGND), U2.17 (SYNC/MODE), U2.19 (NC), U2.24 (PGND), U2.25 (PGND), U2.26 (PGND), U2.27 (NC), U2.28 (NC), U2.29 (NC), U2.30 (NC), U2.31 (EP)
unnamed: C11.1, U2.11 (SS/TRK)
unnamed: C12.2, U2.8 (VCC)
unnamed: C13.1, U2.6 (BOOT)
unnamed: C13.2, L1.1, U2.1 (SW), U2.2 (SW), U2.3 (SW), U2.4 (SW), U2.5 (SW)
unnamed: C14.2, R11.2, R12.1, U2.12 (FB)
unnamed: D3.1 (K), R13.1
unnamed: R9.1, U2.10 (RT)
unnamed: R10.1, U2.16 (PGOOD)
unnamed: U2.7 (NC), U2.23 (NC)
VIN: C8.1, C9.1, C10.1, U2.18 (EN), U2.20 (PVIN), U2.21 (PVIN), U2.22 (PVIN)
