xtech/hw-openmower-worx/GPS.kicad_sch

## KiCad design GPS.kicad_sch (2024-10-06)

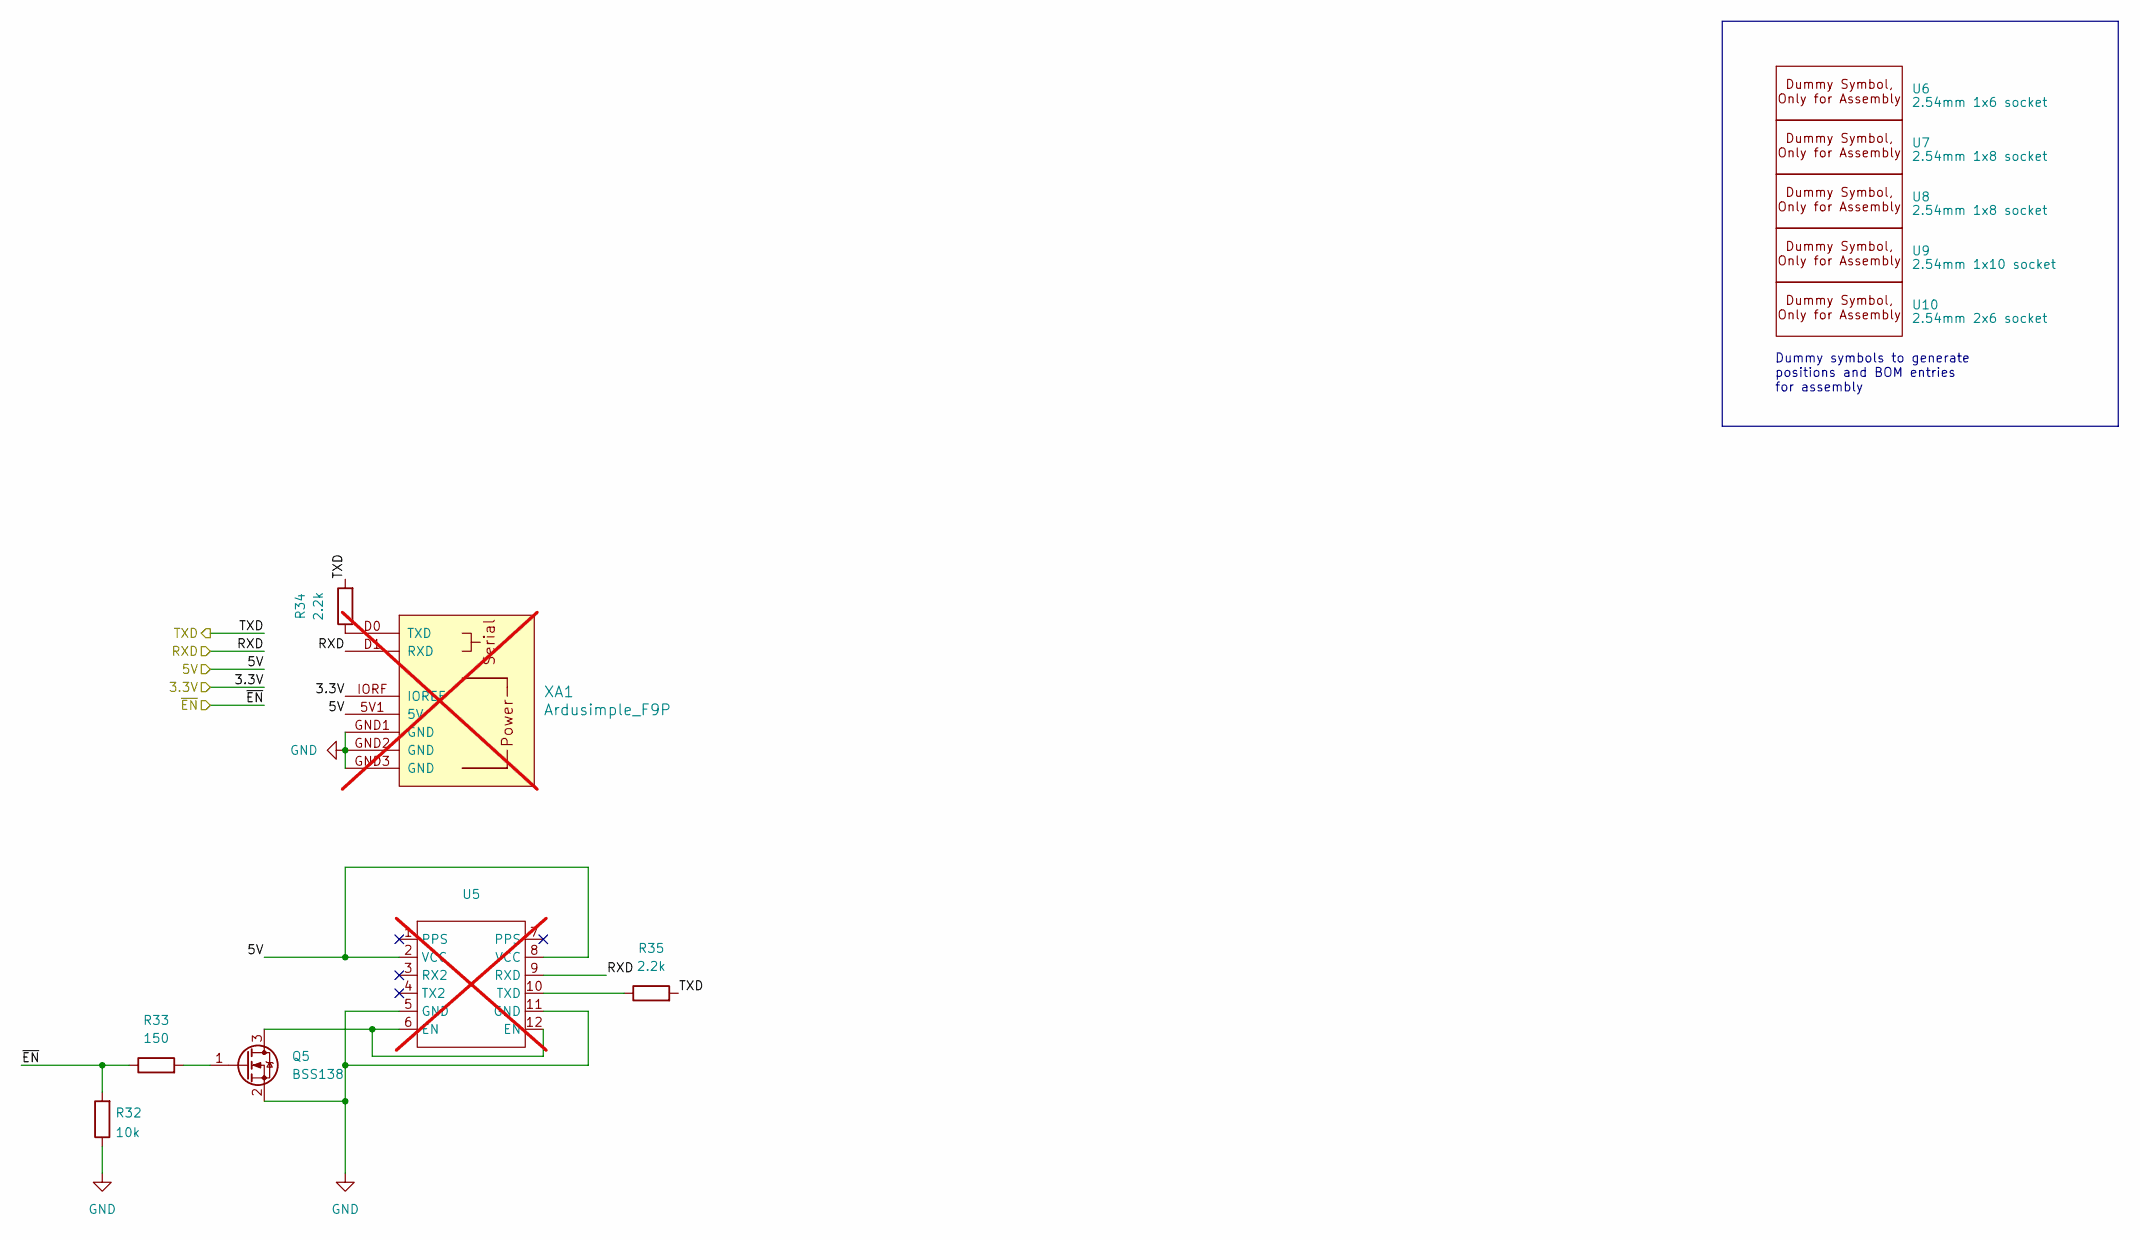
[picture p21: schematic GPS.kicad_sch]

Parts:
Q5: BSS138; SOT-23; Part Number AP2300; Digikey BSS138K-13DICT-ND
R32: 10k; R_0402_1005Metric; Part Number RMCF0805FG10K0; Digikey 738-RMCF0805FG10K0CT-ND
R33: 150; R_0805_2012Metric_Pad1.20x1.40mm_HandSolder; Part Number RC0805FR-07150RL; Digikey 311-150CRCT-ND
R34, R35: 2.2k; R_0805_2012Metric; JLC C17520
U5: UM9XX_WitMotion; not fitted
U6: 2.54mm 1x6 socket; Dummy; JLC C7509518
U7, U8: 2.54mm 1x8 socket; Dummy; JLC C7509515
U9: 2.54mm 1x10 socket; Dummy; JLC C7509514
U10: 2.54mm 2x6 socket; Dummy; JLC C718230
XA1: Ardusimple_F9P; Arduino_Uno_Shield_Ardusimple_Budget; not fitted

Connections:
3.3V: XA1.IORF (IOREF)
5V: U5.2 (VCC), U5.8 (VCC), XA1.5V1 (5V)
GND: Q5.2 (S), R32.1, U5.5 (GND), U5.11 (GND), XA1.GND1 (GND), XA1.GND2 (GND), XA1.GND3 (GND)
unnamed: Q5.1 (G), R33.2
unnamed: Q5.3 (D), U5.6 (EN), U5.12 (EN)
unnamed: R34.1, XA1.D0 (TXD)
unnamed: R35.1, U5.10 (TXD)
unnamed: XA1.3V3 (3.3V), XA1.A0, XA1.A1, XA1.A2, XA1.A3, XA1.A4, XA1.A5, XA1.AREF, XA1.D2 (D2_INT0), XA1.D3 (D3_INT1), XA1.D4, XA1.D5, XA1.D6, XA1.D7, XA1.D8, XA1.D9, XA1.D10 (D10_CS), XA1.D11, XA1.D12, XA1.D13, XA1.RST1 (RESET), XA1.SCL, XA1.SDA, XA1.VIN
RXD: U5.9 (RXD), XA1.D1 (RXD)
TXD: R34.2, R35.2
~EN: R32.2, R33.1

Notes on the sheet:
Dummy symbols to generate positions and BOM entries for assembly
