xtech/hw-openmower-worx/RobotConnectors.kicad_sch

## KiCad design RobotConnectors.kicad_sch (2024-10-06)

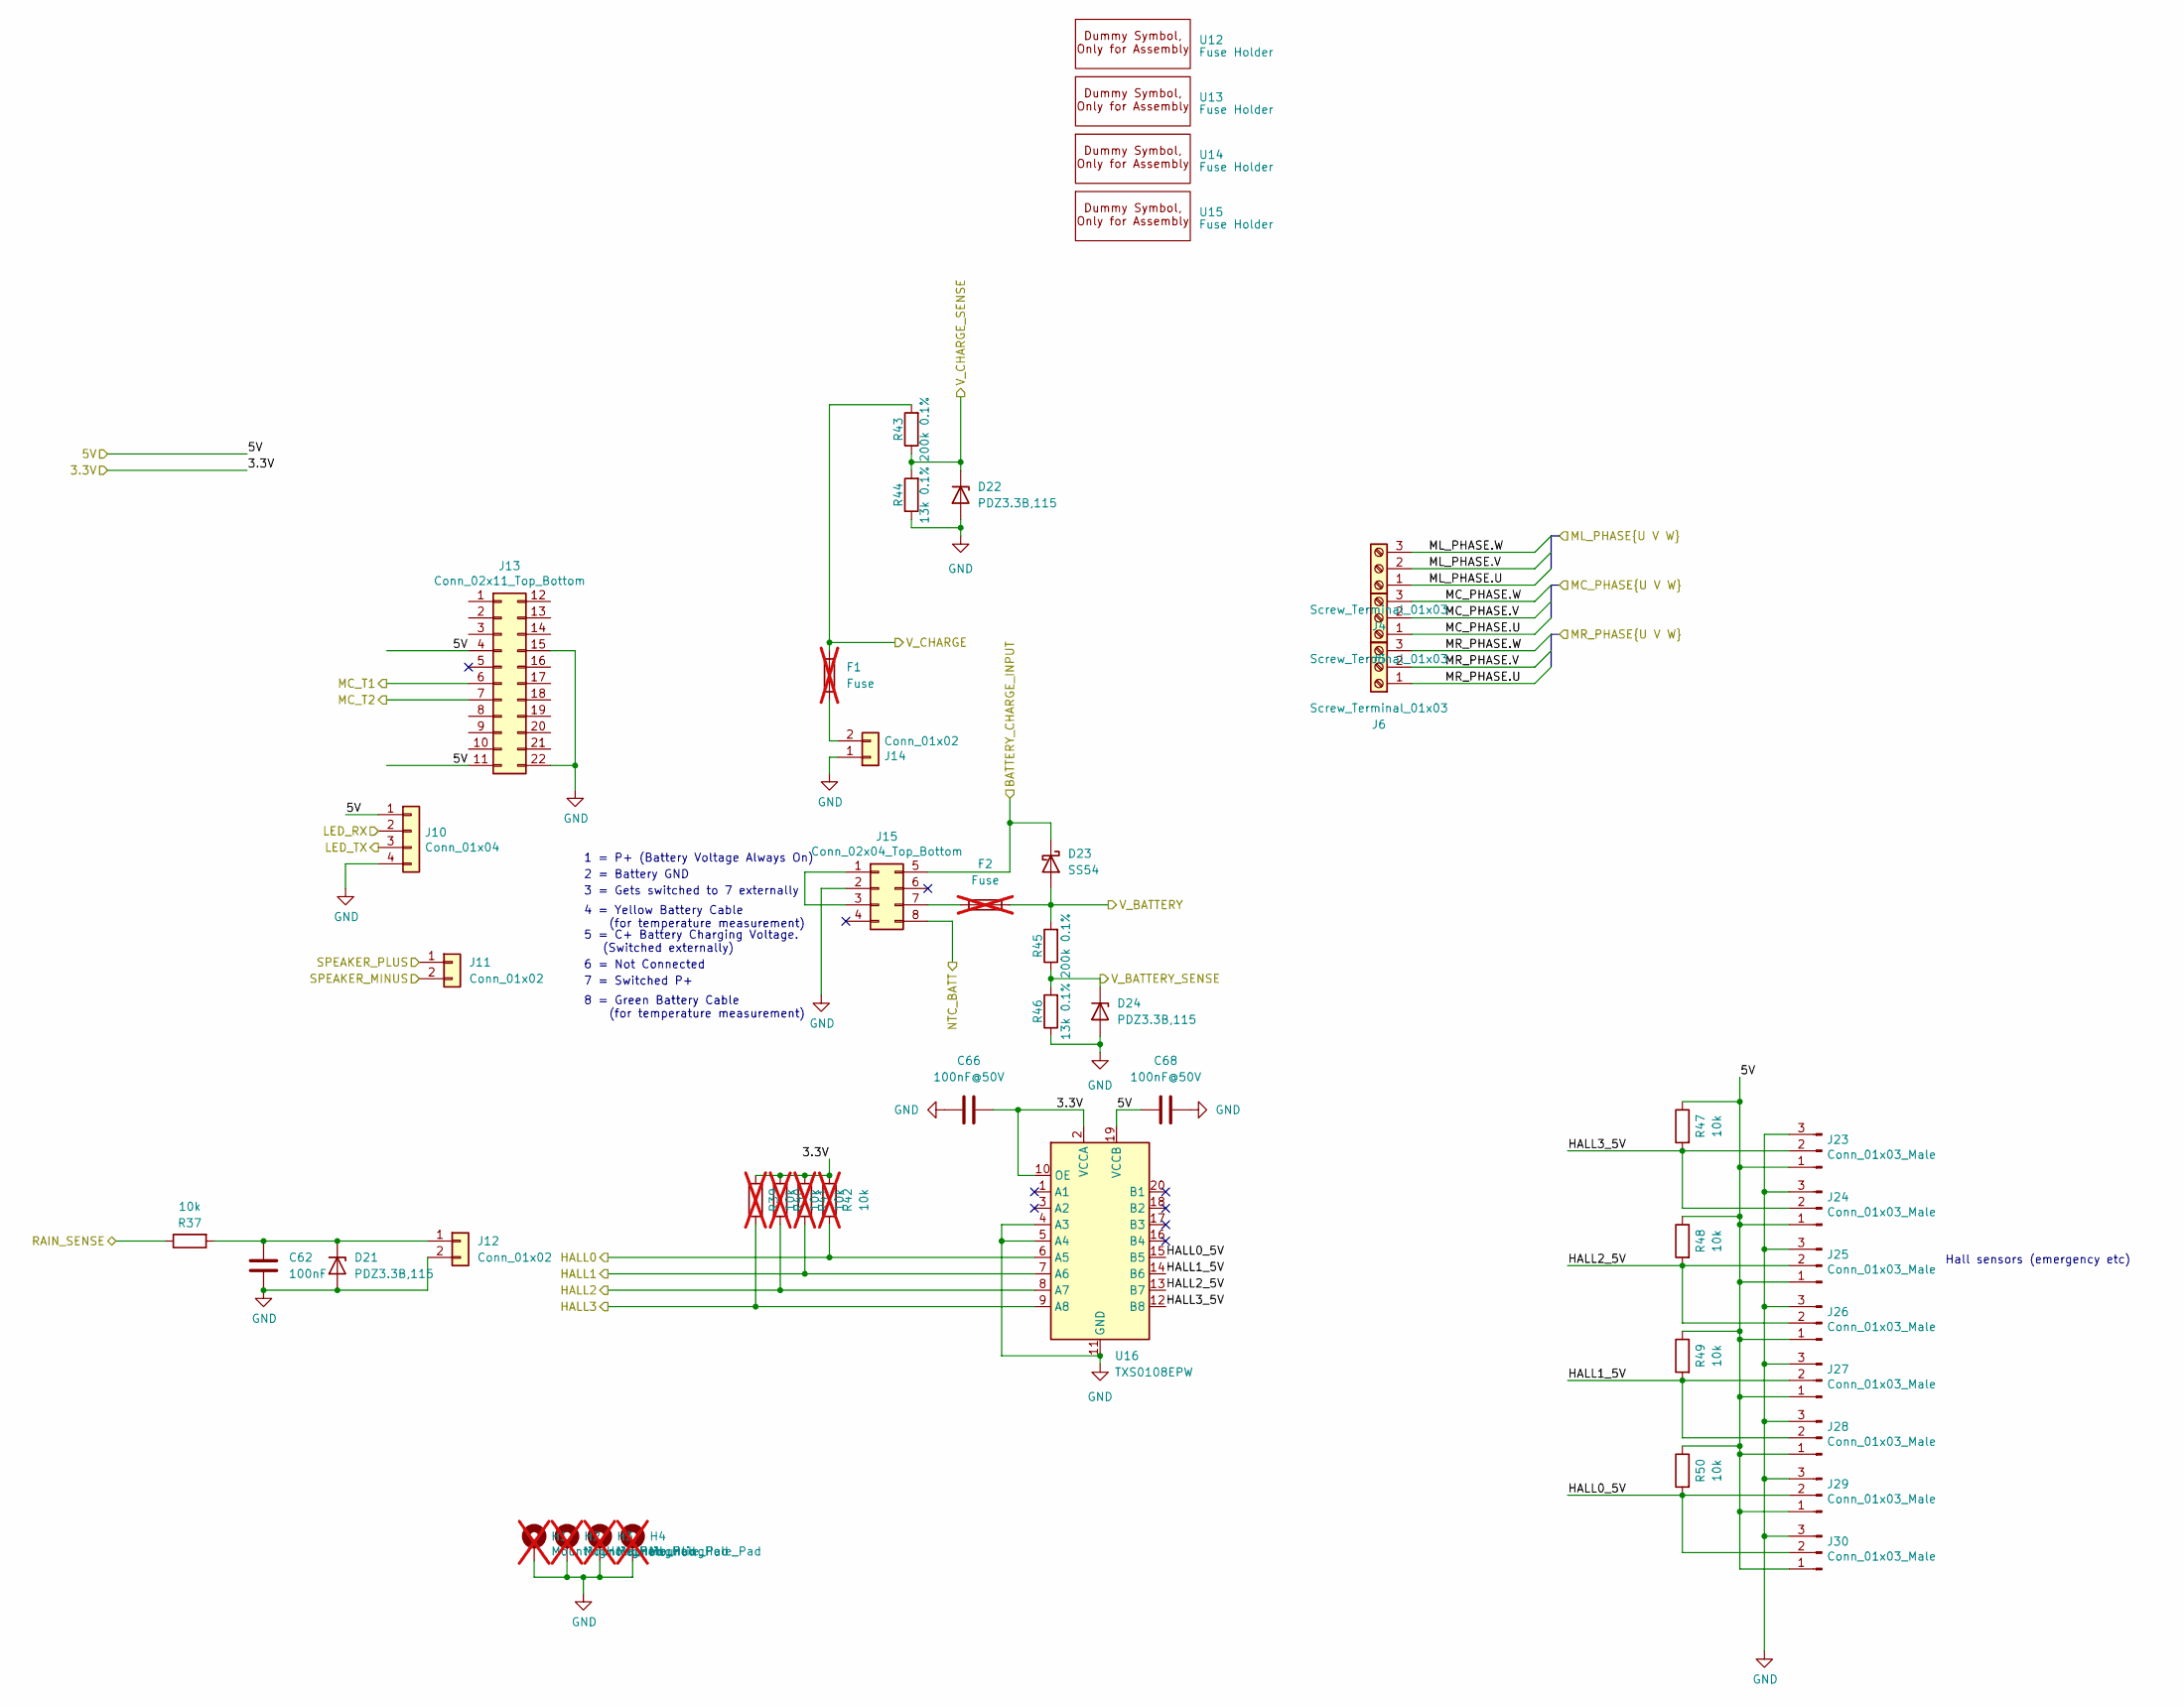
[picture p22: schematic RobotConnectors.kicad_sch]

Parts:
C62: 100nF; C_0402_1005Metric; JLC C307331
C66, C68: 100nF@50V; C_0402_1005Metric; JLC C307331
D21, D22, D24: PDZ3.3B,115; D_SOD-323; JLC C426855
D23: SS54; D_SMA; Part Number SB54AFC_R1_00001; Digikey 3757-SB54AFC_R1_00001CT-ND
F1, F2: Fuse; Fuseholder5x20_horiz_open_inline_Type-I; LCSC C3117; not fitted
H1, H2, H3, H4: MountingHole_Pad; MountingHole_5mm_Pad_Via; not fitted
J4, J5, J6: Screw_Terminal_01x03; TerminalBlock_Phoenix_MKDS-1,5-3_1x03_P5.00mm_Horizontal
J10: Conn_01x04; JST_XH_B4B-XH-A_1x04_P2.50mm_Vertical; Part Number B4B-XH-A(LF)(SN); Digikey 455-2249-ND
J11, J12: Conn_01x02; JST_XH_B2B-XH-A_1x02_P2.50mm_Vertical; Part Number B2B-XH-A-GU; Digikey 455-2946-ND
J13: Conn_02x11_Top_Bottom; Molex_Mini-Fit_Jr_5566-22A_2x11_P4.20mm_Vertical; Part Number 0039288220; Digikey WM23810-ND
J14: Conn_01x02; Molex_Mini-Fit_Jr_5566-02A_2x01_P4.20mm_Vertical; Part Number 0039293026; Digikey WM3843-ND
J15: Conn_02x04_Top_Bottom; Molex_Mini-Fit_Jr_5566-08A_2x04_P4.20mm_Vertical; Part Number 0039310080; Digikey 23-0039310080-ND
J23, J24, J25, J26, J27, J28, J29, J30: Conn_01x03_Male; JST_XH_B3B-XH-A_1x03_P2.50mm_Vertical; Part Number B3B-XH-AM(LF)(SN); Digikey 455-2231-ND
R37, R47, R48, R49, R50: 10k; R_0402_1005Metric; JLC C25744
R39, R40, R41, R42: 10k; R_0402_1005Metric; JLC C25744; not fitted
R43, R45: 200k 0.1%; R_0402_1005Metric; JLC C728556
R44, R46: 13k 0.1%; R_0402_1005Metric; JLC C852524
U12, U13, U14, U15: Fuse Holder; Dummy; JLC C206977
U16: TXS0108EPW; TSSOP-20_4.4x6.5mm_P0.65mm; JLC C17206

Connections:
3.3V: C66.1, R39.1, R40.1, R41.1, R42.1, U16.2 (VCCA), U16.10 (OE)
5V: C68.1, J10.1, J13.4, J13.11, J23.1, J24.1, J25.1, J26.1, J27.1, J28.1, J29.1, J30.1, R47.1, R48.1, R49.1, R50.1, U16.19 (VCCB)
BATTERY_CHARGE_INPUT: D23.1 (K), J15.5
GND: C62.2, C66.2, C68.2, D21.2 (A), D22.2 (A), D24.2 (A), H1.1, H2.1, H3.1, H4.1, J10.4, J12.2, J13.15, J13.22, J14.1, J15.2, J23.3, J24.3, J25.3, J26.3, J27.3, J28.3, J29.3, J30.3, R44.1, R46.1, U16.4 (A3), U16.5 (A4), U16.11 (GND)
HALL0: R42.2, U16.6 (A5)
HALL0_5V: J29.2, J30.2, R50.2, U16.15 (B5)
HALL1: R41.2, U16.7 (A6)
HALL1_5V: J27.2, J28.2, R49.2, U16.14 (B6)
HALL2: R40.2, U16.8 (A7)
HALL2_5V: J25.2, J26.2, R48.2, U16.13 (B7)
HALL3: R39.2, U16.9 (A8)
HALL3_5V: J23.2, J24.2, R47.2, U16.12 (B8)
LED_RX: J10.2
LED_TX: J10.3
MC_PHASE.U: J5.1
MC_PHASE.V: J5.2
MC_PHASE.W: J5.3
MC_T1: J13.6
MC_T2: J13.7
ML_PHASE.U: J4.1
ML_PHASE.V: J4.2
ML_PHASE.W: J4.3
MR_PHASE.U: J6.1
MR_PHASE.V: J6.2
MR_PHASE.W: J6.3
NTC_BATT: J15.8
unnamed: C62.1, D21.1 (K), J12.1, R37.2
unnamed: F1.2, J14.2
unnamed: F2.1, J15.7
unnamed: J15.1, J15.3
RAIN_SENSE: R37.1
SPEAKER_MINUS: J11.2
SPEAKER_PLUS: J11.1
V_BATTERY: D23.2 (A), F2.2, R45.2
V_BATTERY_SENSE: D24.1 (K), R45.1, R46.2
V_CHARGE: F1.1, R43.2
V_CHARGE_SENSE: D22.1 (K), R43.1, R44.2

Notes on the sheet:
3 = Gets switched to 7 externally
8 = Green Battery Cable (for temperature measurement)
7 = Switched P+
2 = Battery GND
4 = Yellow Battery Cable (for temperature measurement)
6 = Not Connected
5 = C+ Battery Charging Voltage. (Switched externally)
1 = P+ (Battery Voltage Always On)
Hall sensors (emergency etc)
