xtech/hw-openmower-worx/hw-openmower-worx.kicad_sch

## KiCad design hw-openmower-worx.kicad_sch (2024-10-06)

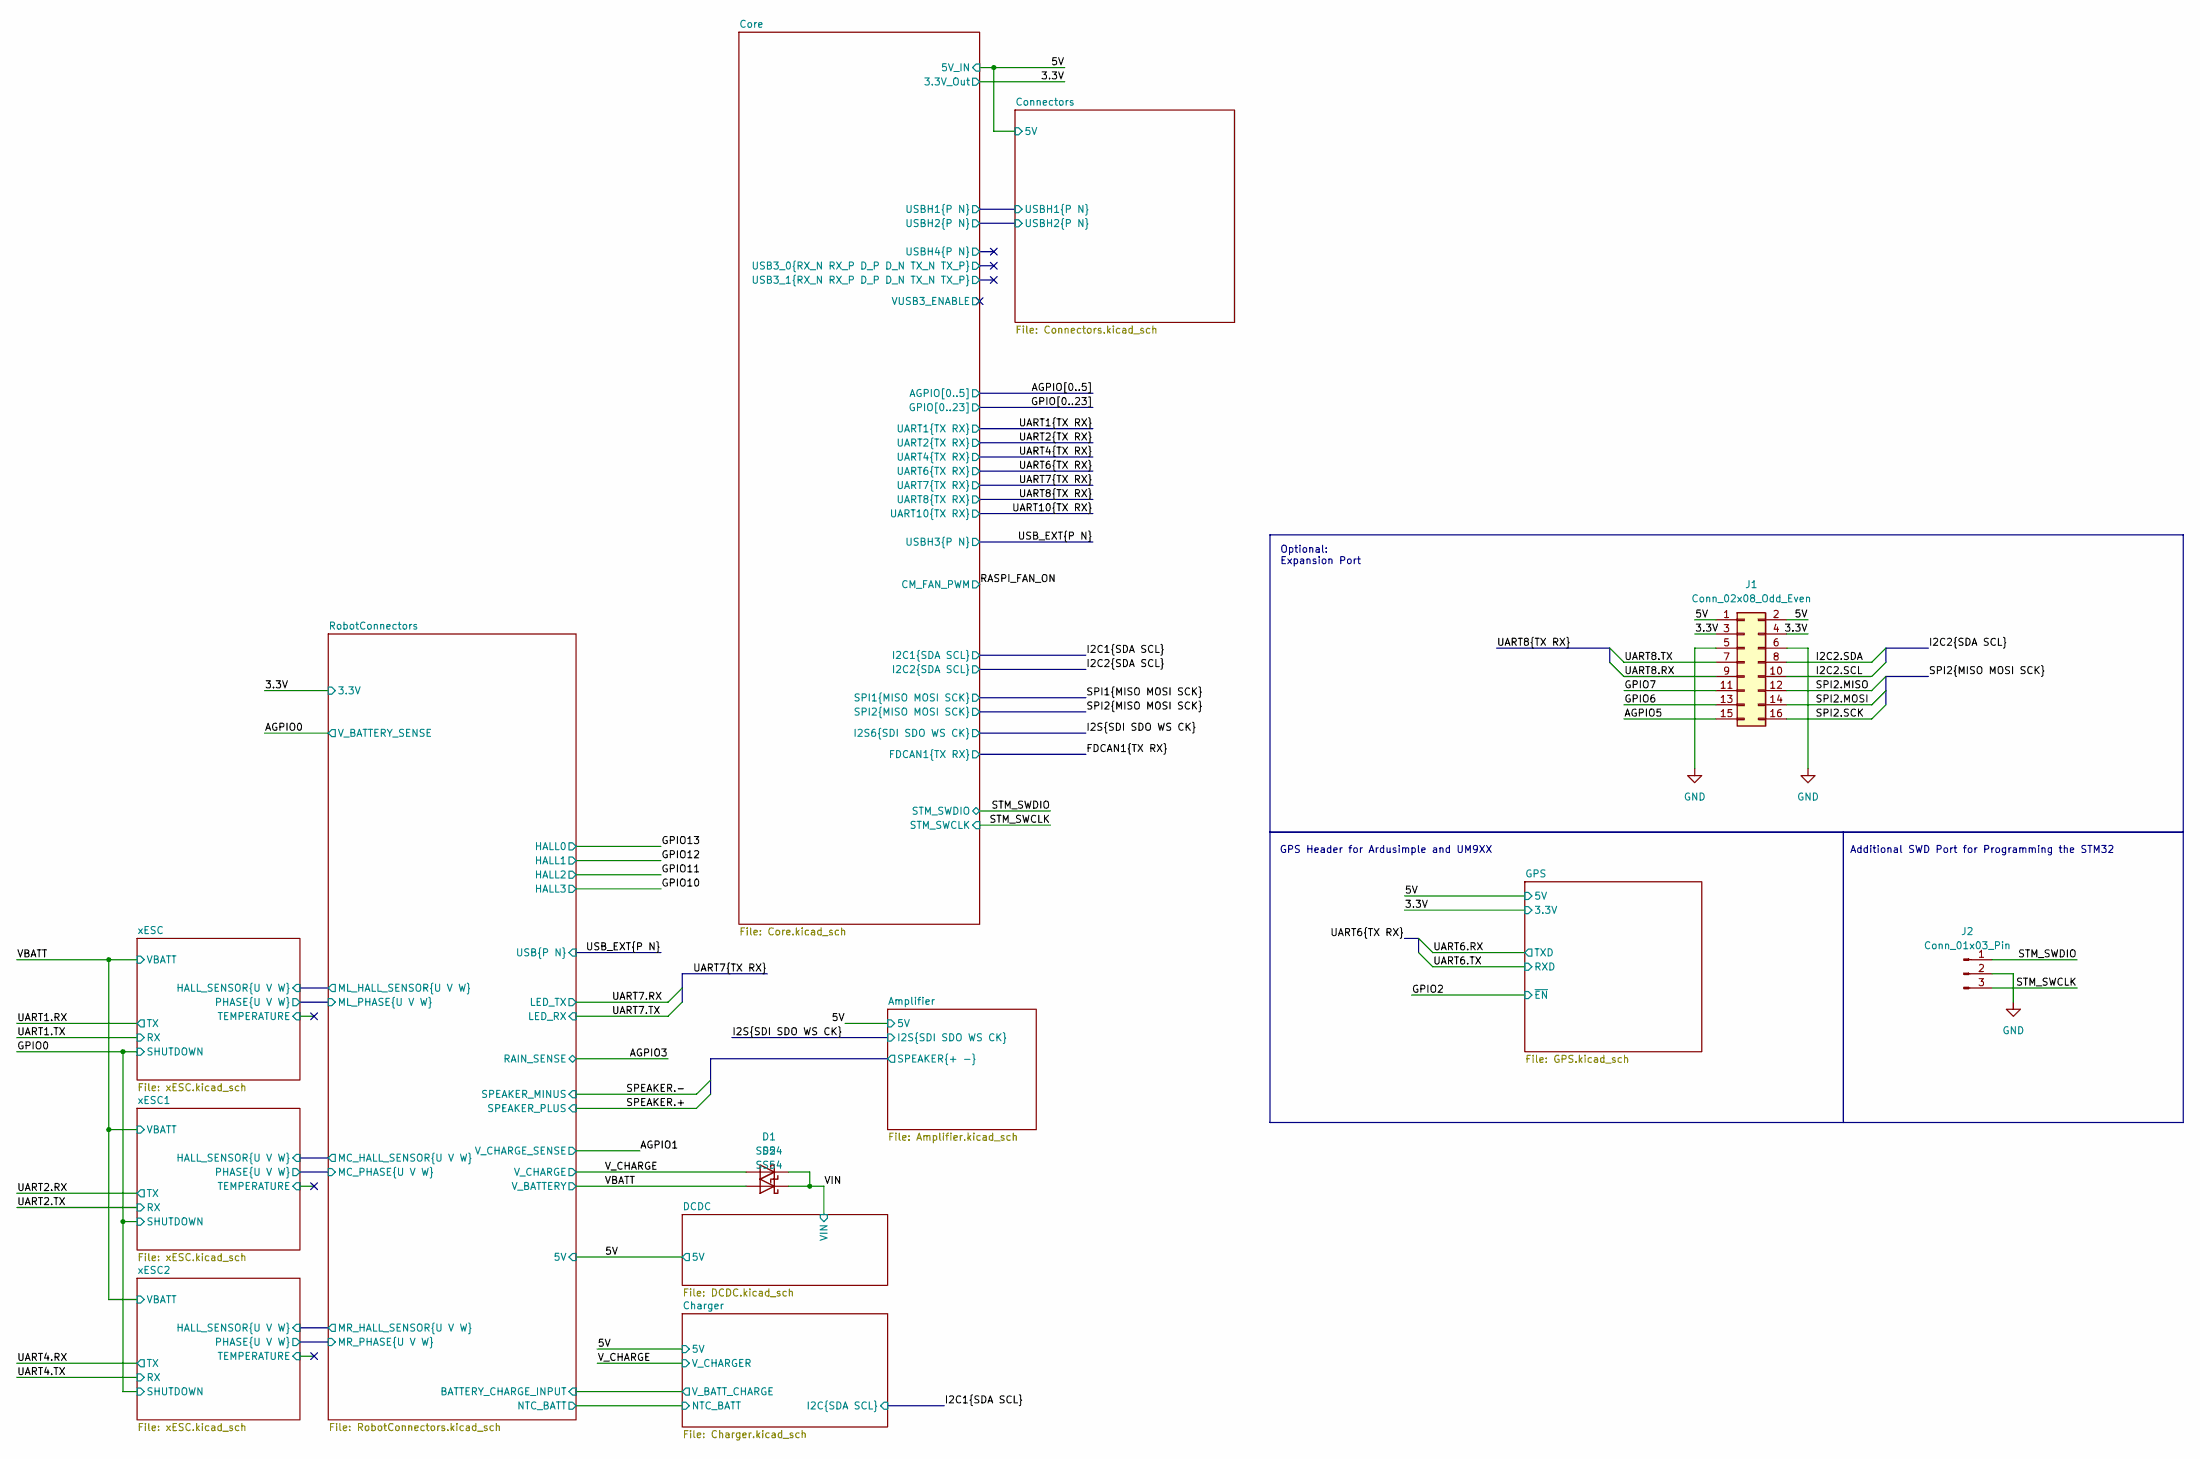
[picture p23: schematic hw-openmower-worx.kicad_sch]

Parts:
D1, D2: SS54; D_SMA; Part Number SB54AFC_R1_00001; Digikey 3757-SB54AFC_R1_00001CT-ND
J1: Conn_02x08_Odd_Even; PinHeader_2x08_P2.54mm_Vertical; JLC C779499
J2: Conn_01x03_Pin; PinHeader_1x03_P2.54mm_Vertical

Connections:
3.3V: J1.3, J1.4
5V: J1.1, J1.2
AGPIO5: J1.15
GND: J1.5, J1.6, J2.2
GPIO6: J1.13
GPIO7: J1.11
I2C2.SCL: J1.10
I2C2.SDA: J1.8
SPI2.MISO: J1.12
SPI2.MOSI: J1.14
SPI2.SCK: J1.16
STM_SWCLK: J2.3
STM_SWDIO: J2.1
UART8.RX: J1.9
UART8.TX: J1.7
VBATT: D2.2 (A)
VIN: D1.1 (K), D2.1 (K)
V_CHARGE: D1.2 (A)

Notes on the sheet:
Additional SWD Port for Programming the STM32
GPS Header for Ardusimple and UM9XX
Optional: Expansion Port
