xtech/hw-openmower-worx/xESC.kicad_sch

## KiCad design xESC.kicad_sch (2024-10-06)

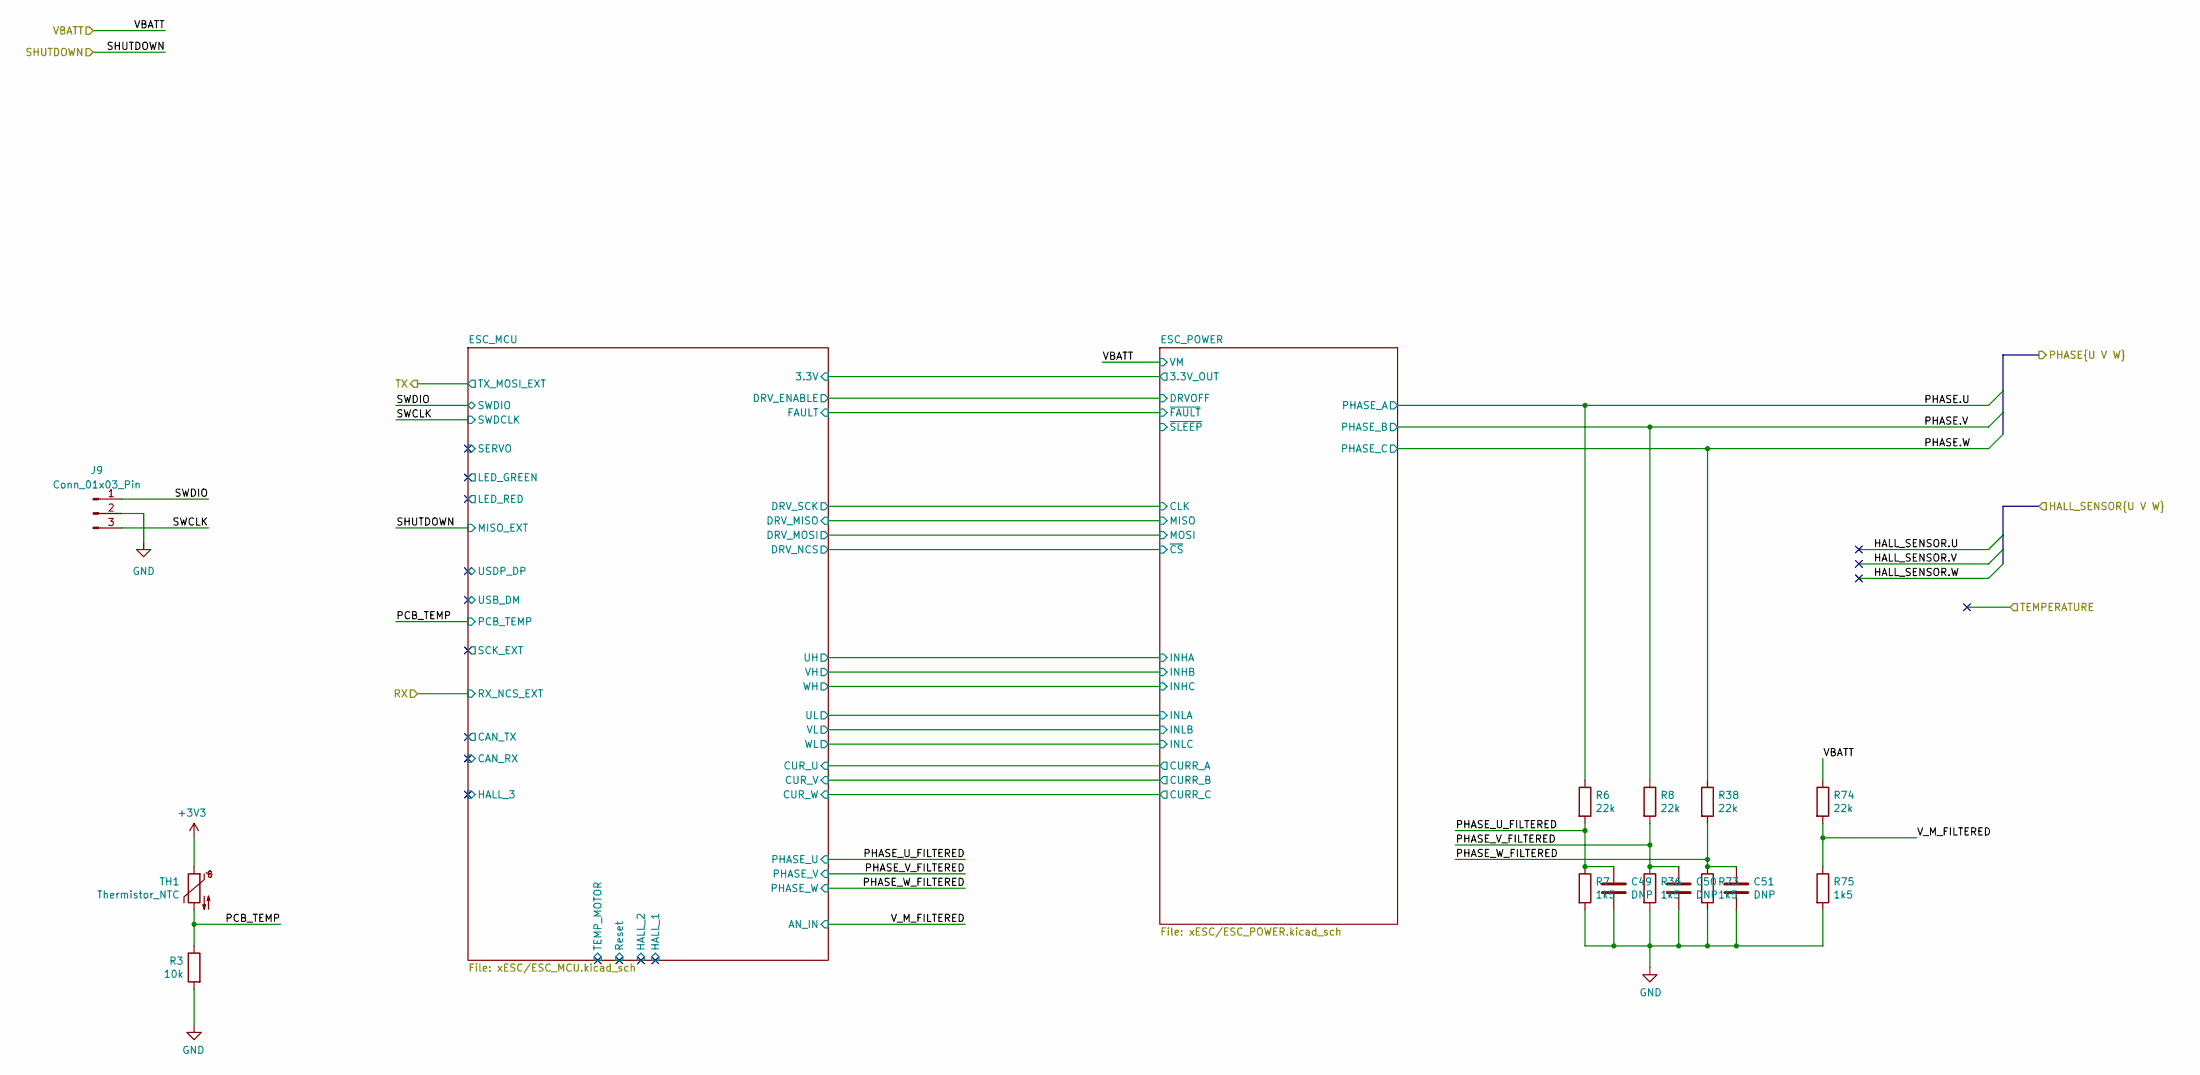
[picture p24: schematic xESC.kicad_sch]

Parts:
C49, C50, C51: DNP; C_0402_1005Metric
J9: Conn_01x03_Pin; PinHeader_1x03_P2.54mm_Vertical
R3: 10k; R_0402_1005Metric; Part Number RC0603FR-0710KL; Digikey 311-10.0KHRCT-ND
R6, R8, R38, R74: 22k; R_0402_1005Metric; Part Number RMCF0603FT22K0; Digikey RMCF0603FT22K0CT-ND
R7, R36, R73, R75: 1k5; R_0402_1005Metric; Part Number RC0603FR-071K5L; Digikey 311-1.50KHRCT-ND
TH1: Thermistor_NTC; R_0603_1608Metric; Part Number NCU18XH103F60RB; Digikey 490-16279-1-ND

Connections:
+3V3: TH1.1
GND: C49.2, C50.2, C51.2, J9.2, R3.2, R7.2, R36.2, R73.2, R75.2
PCB_TEMP: R3.1, TH1.2
PHASE.U: R6.1
PHASE.V: R8.1
PHASE.W: R38.1
PHASE_U_FILTERED: C49.1, R6.2, R7.1
PHASE_V_FILTERED: C50.1, R8.2, R36.1
PHASE_W_FILTERED: C51.1, R38.2, R73.1
SWCLK: J9.3
SWDIO: J9.1
VBATT: R74.1
V_M_FILTERED: R74.2, R75.1
