xtech/hw-openmower-worx/xESC/ESC_MCU.kicad_sch

## KiCad design xESC/ESC_MCU.kicad_sch (2024-10-06)

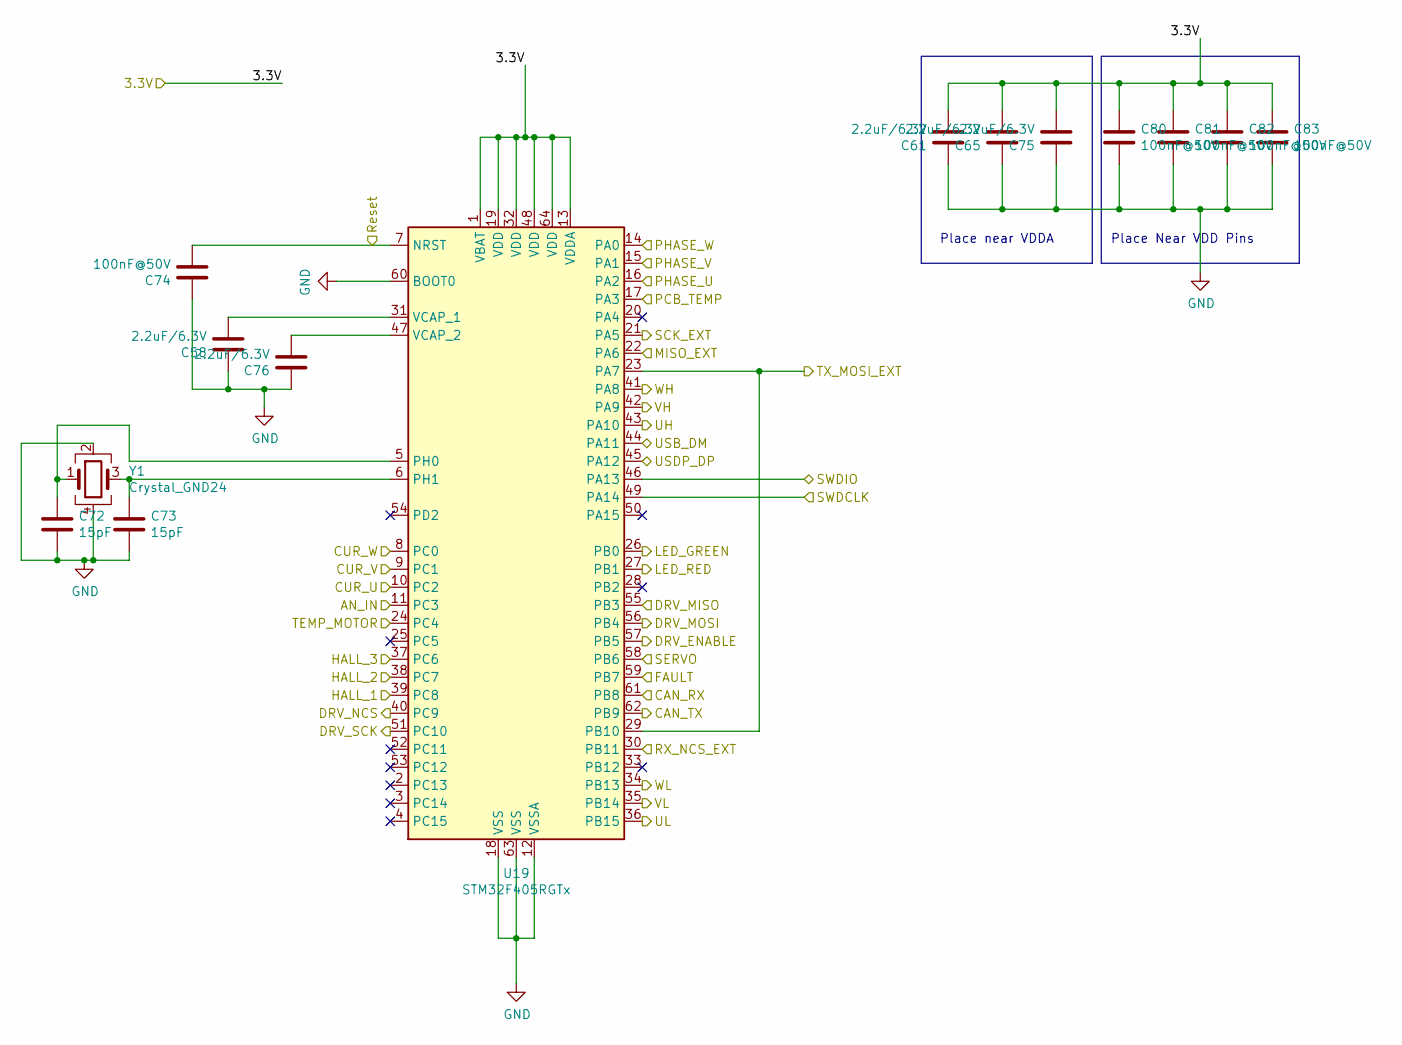
[picture p25: schematic ESC_MCU.kicad_sch]

Parts:
C58, C61, C65, C75, C76: 2.2uF/6.3V; C_0402_1005Metric; Part Number GRM21BR71E225KE11L; Digikey 490-14467-1-ND
C72, C73: 15pF; C_0402_1005Metric; Part Number GRM1885C2A150JA01D; Digikey 490-1331-1-ND
C74, C80, C81, C82, C83: 100nF@50V; C_0402_1005Metric; Part Number CL10B104KC8NNNC; Digikey 1276-1935-1-ND
U19: STM32F405RGTx; LQFP-64_10x10mm_P0.5mm; Part Number STM32F405RGTx; LCSC C15742
Y1: Crystal_GND24; Crystal_SMD_3225-4Pin_3.2x2.5mm; Part Number ECS-80-12-33-JGN-TR; Digikey 50-ECS-80-12-33-JGN-CT-ND

Connections:
3.3V: C61.2, C65.2, C75.2, C80.1, C81.1, C82.1, C83.1, U19.1 (VBAT), U19.13 (VDDA), U19.19 (VDD), U19.32 (VDD), U19.48 (VDD), U19.64 (VDD)
AN_IN: U19.11 (PC3)
CAN_RX: U19.61 (PB8)
CAN_TX: U19.62 (PB9)
CUR_U: U19.10 (PC2)
CUR_V: U19.9 (PC1)
CUR_W: U19.8 (PC0)
DRV_ENABLE: U19.57 (PB5)
DRV_MISO: U19.55 (PB3)
DRV_MOSI: U19.56 (PB4)
DRV_NCS: U19.40 (PC9)
DRV_SCK: U19.51 (PC10)
FAULT: U19.59 (PB7)
GND: C58.1, C61.1, C65.1, C72.2, C73.2, C74.1, C75.1, C76.1, C80.2, C81.2, C82.2, C83.2, U19.12 (VSSA), U19.18 (VSS), U19.60 (BOOT0), U19.63 (VSS), Y1.2, Y1.4
HALL_1: U19.39 (PC8)
HALL_2: U19.38 (PC7)
HALL_3: U19.37 (PC6)
LED_GREEN: U19.26 (PB0)
LED_RED: U19.27 (PB1)
MISO_EXT: U19.22 (PA6)
unnamed: C58.2, U19.31 (VCAP_1)
unnamed: C72.1, U19.5 (PH0), Y1.1
unnamed: C73.1, U19.6 (PH1), Y1.3
unnamed: C76.2, U19.47 (VCAP_2)
PCB_TEMP: U19.17 (PA3)
PHASE_U: U19.16 (PA2)
PHASE_V: U19.15 (PA1)
PHASE_W: U19.14 (PA0)
RX_NCS_EXT: U19.30 (PB11)
Reset: C74.2, U19.7 (NRST)
SCK_EXT: U19.21 (PA5)
SERVO: U19.58 (PB6)
SWDCLK: U19.49 (PA14)
SWDIO: U19.46 (PA13)
TEMP_MOTOR: U19.24 (PC4)
TX_MOSI_EXT: U19.23 (PA7), U19.29 (PB10)
UH: U19.43 (PA10)
UL: U19.36 (PB15)
USB_DM: U19.44 (PA11)
USDP_DP: U19.45 (PA12)
VH: U19.42 (PA9)
VL: U19.35 (PB14)
WH: U19.41 (PA8)
WL: U19.34 (PB13)

Notes on the sheet:
Place Near VDD Pins
Place near VDDA
