xtech/hw-openmower-worx/xESC/ESC_POWER.kicad_sch

## KiCad design xESC/ESC_POWER.kicad_sch (2024-10-06)

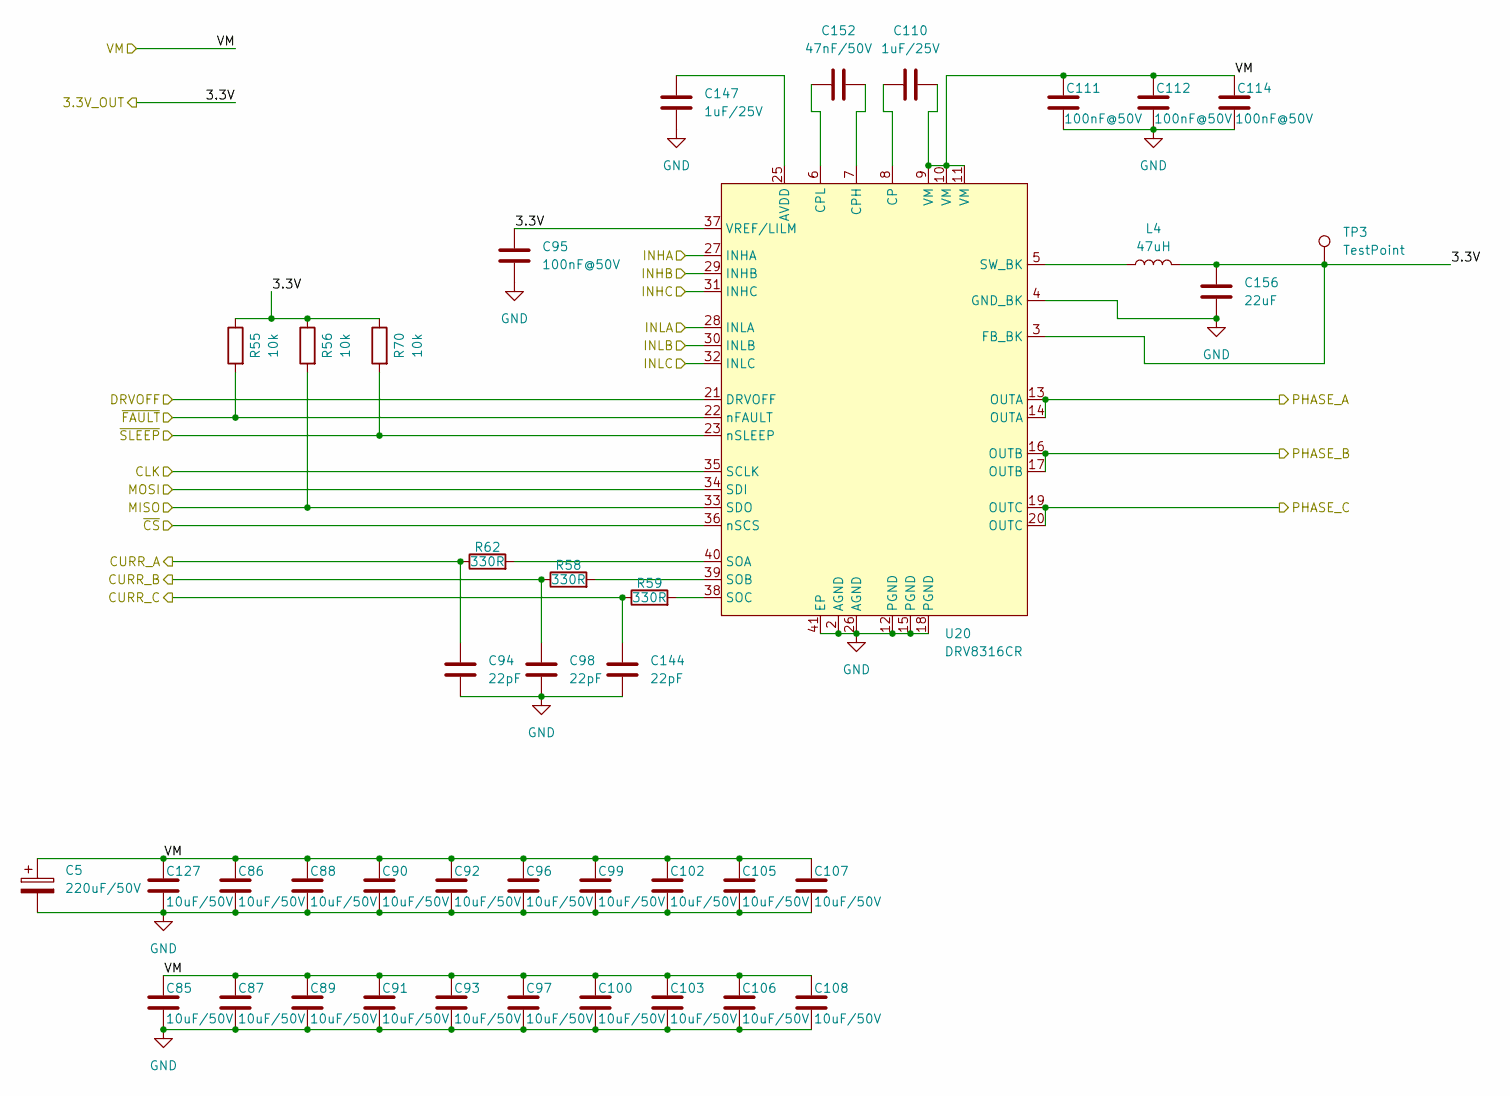
[picture p26: schematic ESC_POWER.kicad_sch]

Parts:
C5: 220uF/50V; CP_Elec_10x10.5; JLC C343913
C85, C86, C87, C88, C89, C90, C91, C92, C93, C96, C97, C99, C100, C102, C103, C105, C106, C107, C108, C127: 10uF/50V; C_0805_2012Metric; JLC C440198
C94, C98, C144: 22pF; C_0603_1608Metric; JLC 0603
C95, C111, C112, C114: 100nF@50V; C_0402_1005Metric; JLC C307331
C110, C147: 1uF/25V; C_0402_1005Metric; JLC C52923
C152: 47nF/50V; C_0603_1608Metric; JLC C1622
C156: 22uF; C_0805_2012Metric; JLC C45783
L4: 47uH; L_Changjiang_FNR3015S; JLC C167766
R55, R56, R70: 10k; R_0402_1005Metric; JLC C25744
R58, R59, R62: 330R; R_0603_1608Metric; JLC C23138
TP3: TestPoint; Pin_D0.7mm_L6.5mm_W1.8mm_FlatFork
U20: DRV8316CR; DRV8316; JLC C5447274

Connections:
3.3V: C95.1, C156.2, L4.2, R55.1, R56.1, R70.1, TP3.1, U20.3 (FB_BK), U20.37 (VREF/LILM)
CLK: U20.35 (SCLK)
CURR_A: C94.1, R62.1
CURR_B: C98.1, R58.1
CURR_C: C144.1, R59.1
DRVOFF: U20.21 (DRVOFF)
GND: C5.2, C85.2, C86.2, C87.2, C88.2, C89.2, C90.2, C91.2, C92.2, C93.2, C94.2, C95.2, C96.2, C97.2, C98.2, C99.2, C100.2, C102.2, C103.2, C105.2, C106.2, C107.2, C108.2, C111.2, C112.2, C114.2, C127.2, C144.2, C147.2, C156.1, U20.2 (AGND), U20.4 (GND_BK), U20.12 (PGND), U20.15 (PGND), U20.18 (PGND), U20.26 (AGND), U20.41 (EP)
INHA: U20.27 (INHA)
INHB: U20.29 (INHB)
INHC: U20.31 (INHC)
INLA: U20.28 (INLA)
INLB: U20.30 (INLB)
INLC: U20.32 (INLC)
MISO: R56.2, U20.33 (SDO)
MOSI: U20.34 (SDI)
unnamed: C110.1, U20.8 (CP)
unnamed: C147.1, U20.25 (AVDD)
unnamed: C152.1, U20.6 (CPL)
unnamed: C152.2, U20.7 (CPH)
unnamed: L4.1, U20.5 (SW_BK)
unnamed: R58.2, U20.39 (SOB)
unnamed: R59.2, U20.38 (SOC)
unnamed: R62.2, U20.40 (SOA)
PHASE_A: U20.13 (OUTA), U20.14 (OUTA)
PHASE_B: U20.16 (OUTB), U20.17 (OUTB)
PHASE_C: U20.19 (OUTC), U20.20 (OUTC)
VM: C5.1, C85.1, C86.1, C87.1, C88.1, C89.1, C90.1, C91.1, C92.1, C93.1, C96.1, C97.1, C99.1, C100.1, C102.1, C103.1, C105.1, C106.1, C107.1, C108.1, C110.2, C111.1, C112.1, C114.1, C127.1, U20.9 (VM), U20.10 (VM), U20.11 (VM)
~CS: U20.36 (nSCS)
~FAULT: R55.2, U20.22 (nFAULT)
~SLEEP: R70.2, U20.23 (nSLEEP)
