xtech/hw-openmower-worx/(notices)

Notices in the files:
xESC/ESC_MCU.kicad_sch:
Creative Commons Attribution-NonCommercial-ShareAlike 4.0 International License.
